Dinca-Mihai/Analog-Signal-Conditioning-Interface/AnalogSignalConditioningInterface.pdf

# Proiect SCIA

Profesor indrumator:

Alessandro Battigelli

Vladu Eduard

Student: Dinca Mihai Mircea

Anul III, EA, Grupa 2131

# Cuprins

## Capitolul 1. Cerinte de proiectare

## Specificatii generale:

## Proiectarea unei interfete analogice formate din urmatoarele blocuri conectate in cascada:

1. un preamplificator/amplificator de instrumentatie cu intrare diferentiala/single ended in tensiune/curent si iesire in tensiune/current 2. un filtru analogic trece jos/trece banda cu intrare in tensiune/curent si iesire in tensiune 3. un amplificator cu castig programabil 4. un peak detector/redresor de precizie / convertor AC-DC / circuit Sample&Hold

## Schema bloc circuit:

Figura 1- Schema Bloc Circuit

## Capitolul 2. Circuit electric – proiectare si simulare

## Etaj 1 – Amplificator

## Specificatii individuale:

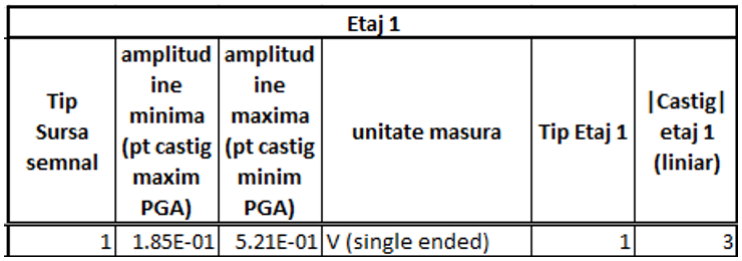
[picture p1: figure]

Figura 2 - Specificatii individuale etaj1

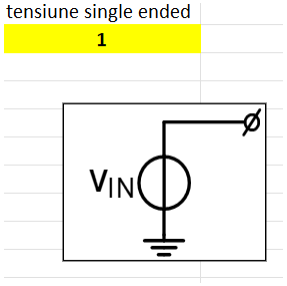
[picture p2: figure]

Figura 3 – Sursa

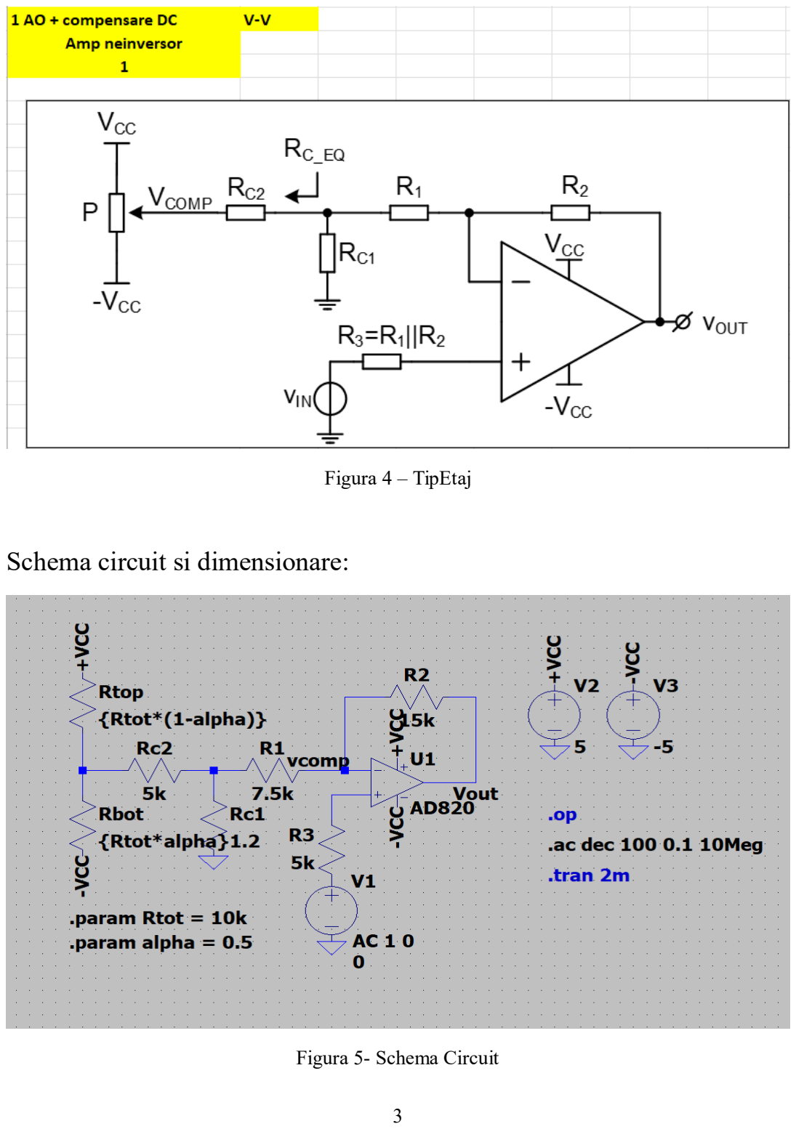
[picture p3: page 5]

Figura 4 – TipEtaj

## Schema circuit si dimensionare:

Figura 5- Schema Circuit

## Dimensionare:

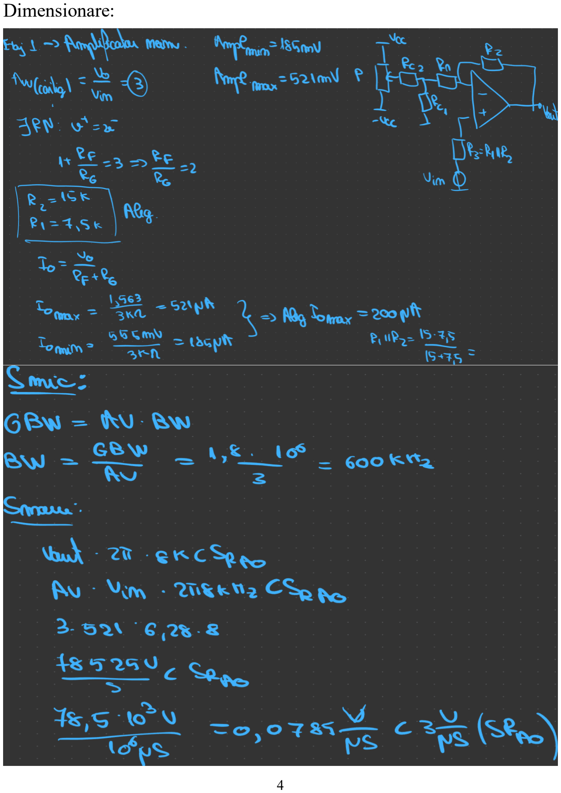
[picture p4: page 6]
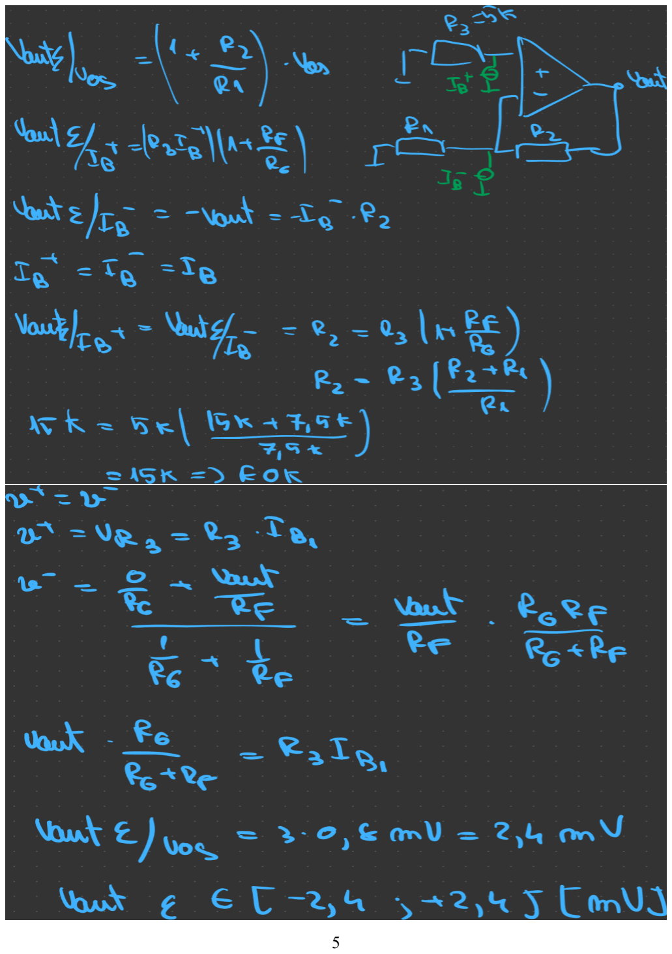
[picture p5: page 7]
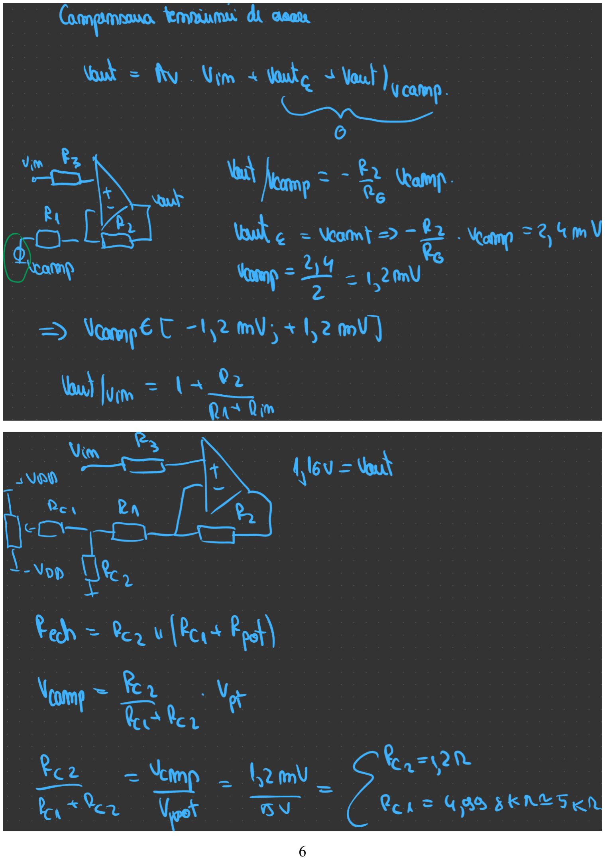
[picture p6: page 8]

## Simulari:

## - DCOP

## Punct static de functionare:

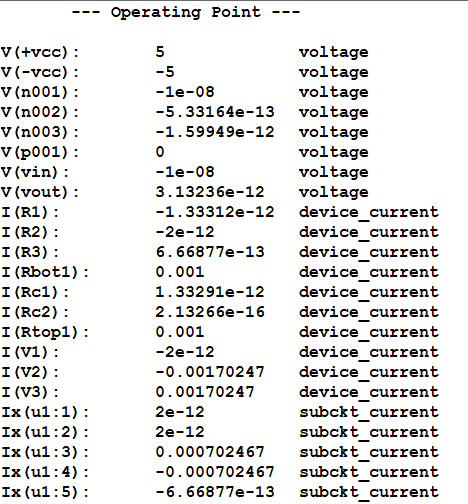
[picture p7: figure]

Figura 6 - punct static de functionare

## Compensare DC:

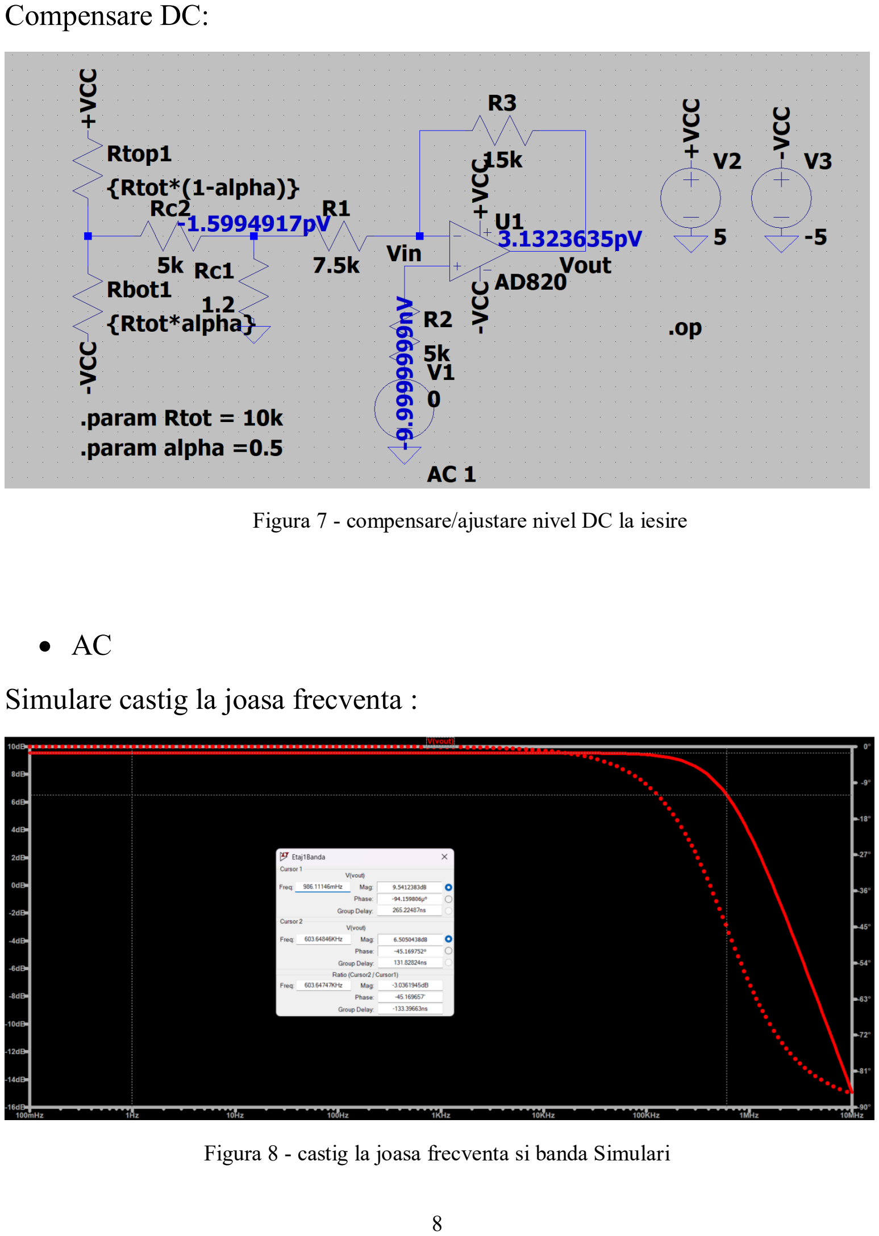
[picture p8: page 10]

Figura 7 - compensare/ajustare nivel DC la iesire

- AC

## Simulare castig la joasa frecventa :

Figura 8 - castig la joasa frecventa si banda Simulari

## Castig joasa frecventa masurat:

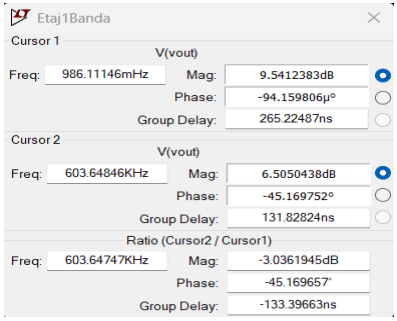
[picture p9: figure]

Figura 9 - castig la joasa frecventa si banda Masuratori

## - Transient

## Setare sursei pentru masurarea SR:

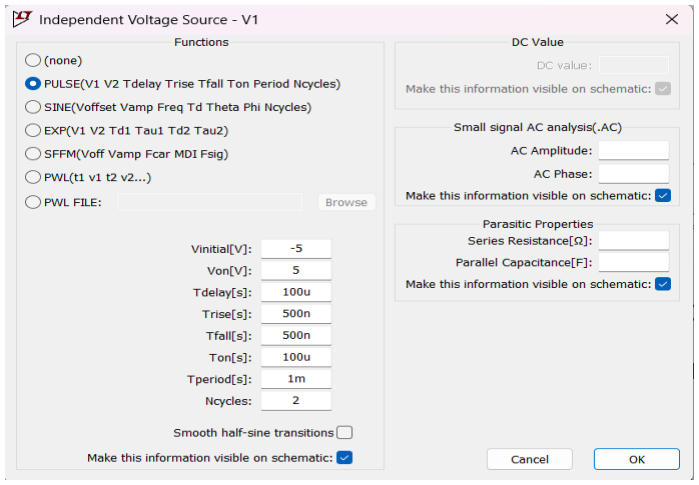
[picture p10: figure]

Figura 10 – Sursa V1 pentru masurare SR

## SR Simulare:

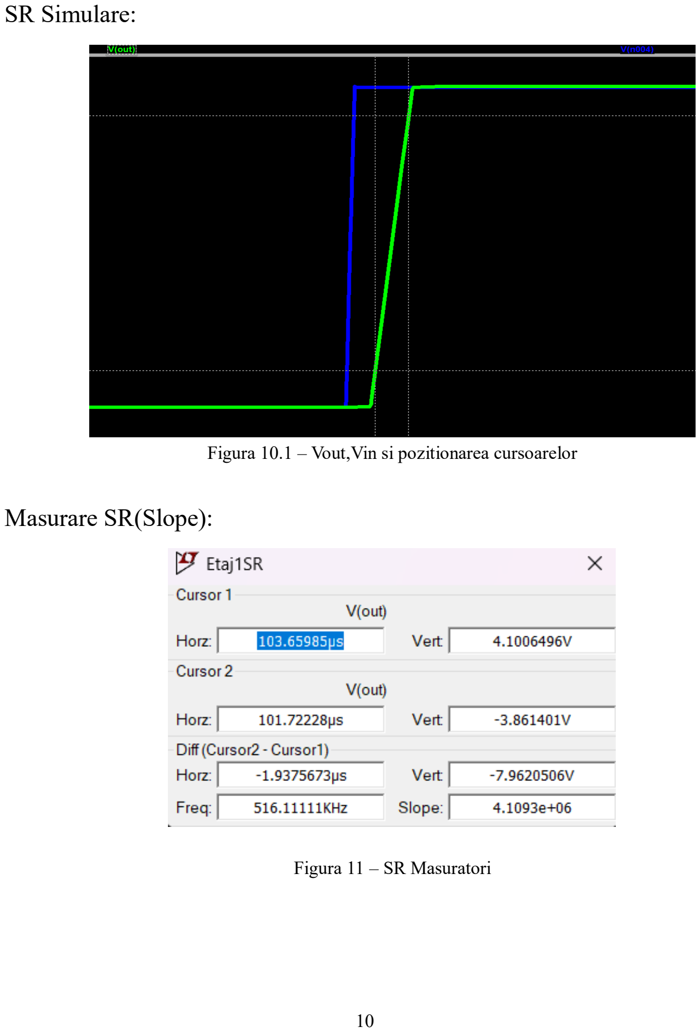
[picture p11: page 12]

Figura 10.1 – Vout,Vin si pozitionarea cursoarelor

## Masurare SR(Slope):

Figura 11 – SR Masuratori

## Analiza tranzitorie semal de iesire:

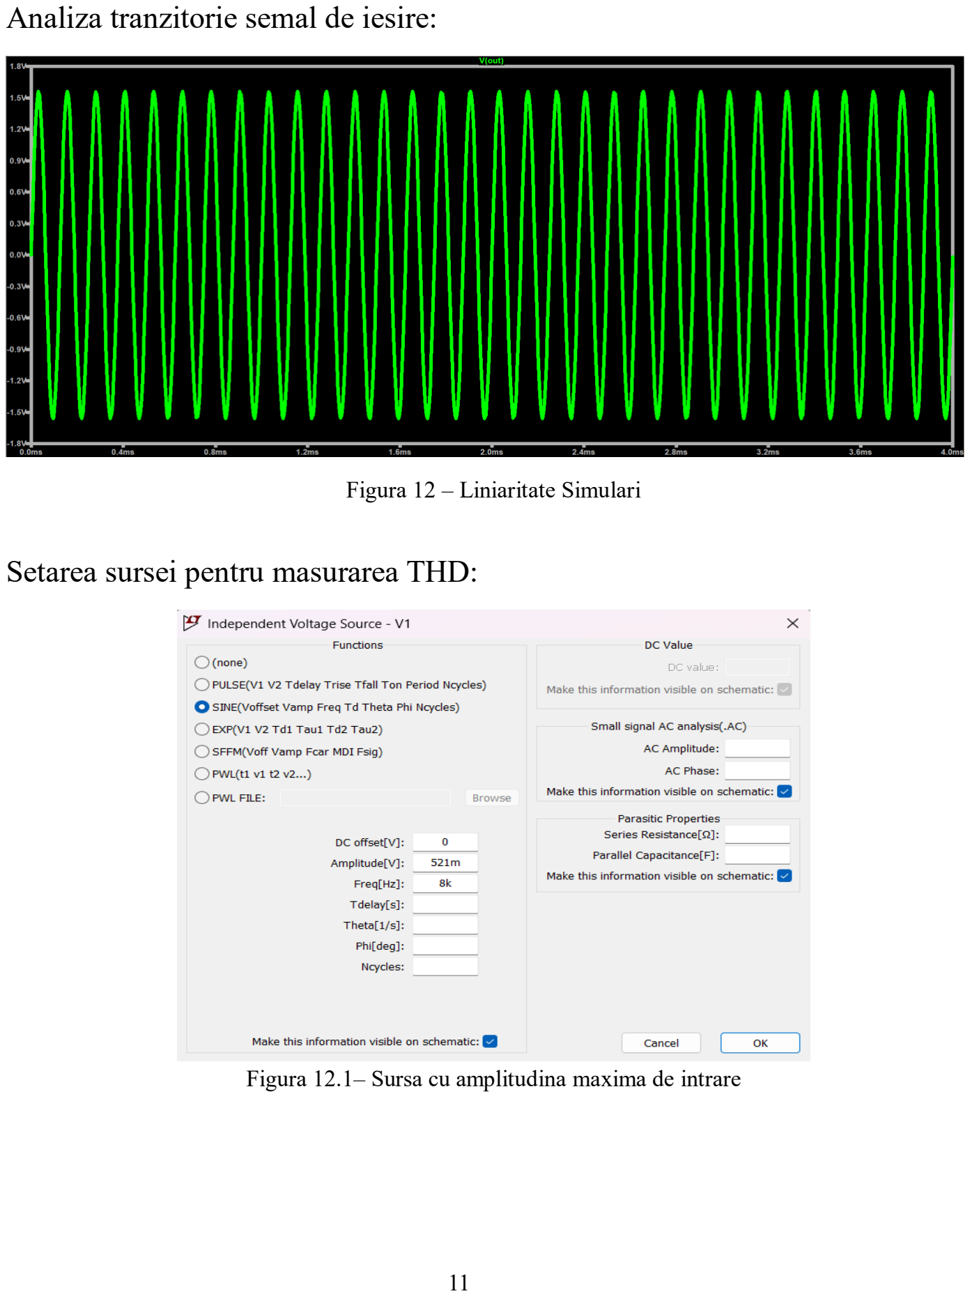
[picture p12: page 13]

Figura 12 – Liniaritate Simulari

## Setarea sursei pentru masurarea THD:

Figura 12.1– Sursa cu amplitudina maxima de intrare

## FFT:

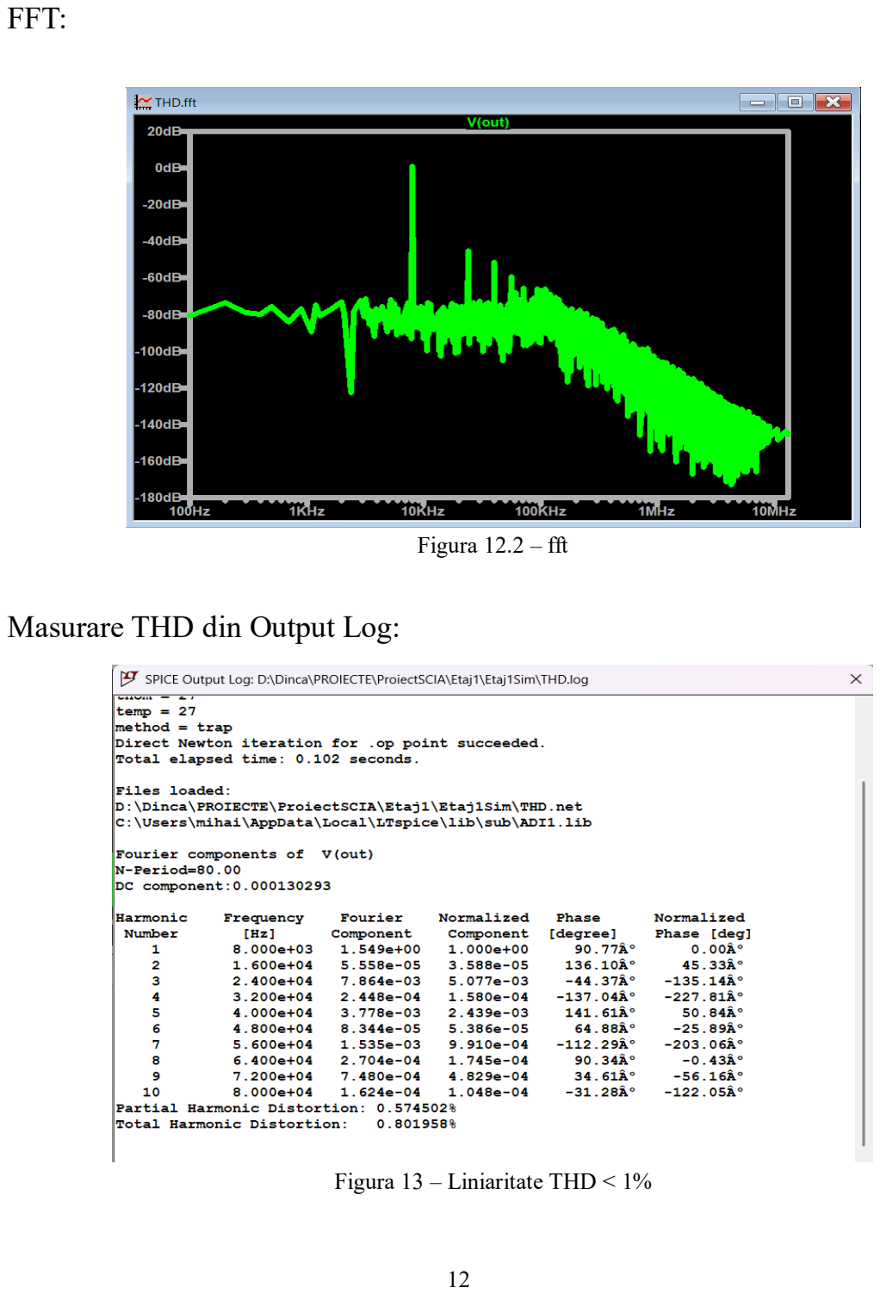
[picture p13: page 14]

Figura 12.2 – fft

## Masurare THD din Output Log:

Figura 13 – Liniaritate THD < 1%

## Etaj 2 – Filtru

## Specificatii individuale:

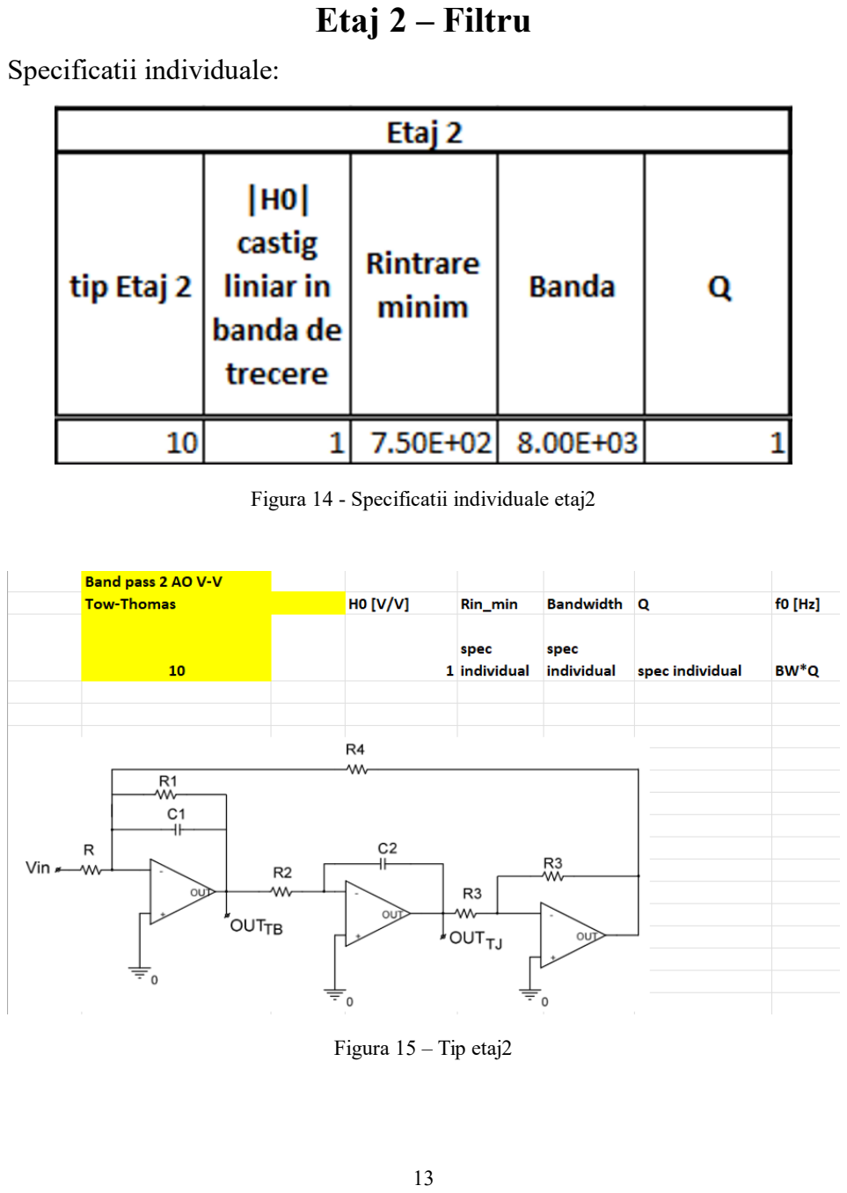
[picture p14: page 15]

Figura 14 - Specificatii individuale etaj2

Figura 15 – Tip etaj2

## Schema circuit si dimensionare:

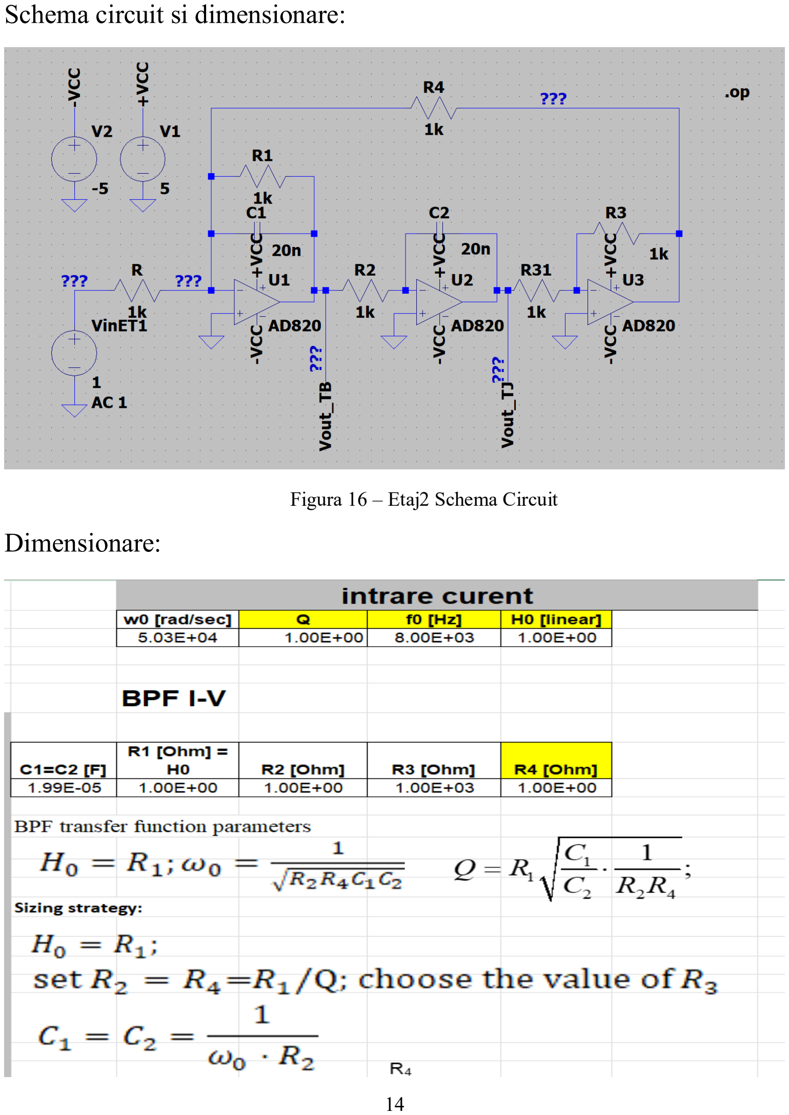
[picture p15: page 16]

Figura 16 – Etaj2 Schema Circuit

## Dimensionare:

## Simulari:

## - DCOP

## Punct static de functionare:

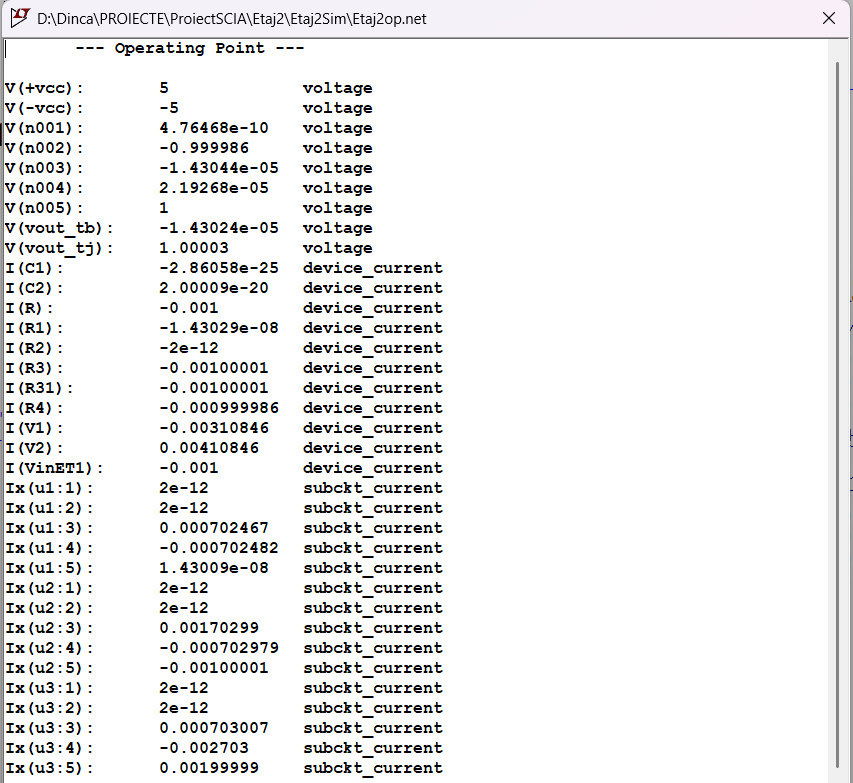
[picture p16: figure]

Figura 17 – OP

- AC

## Banda de trecere:

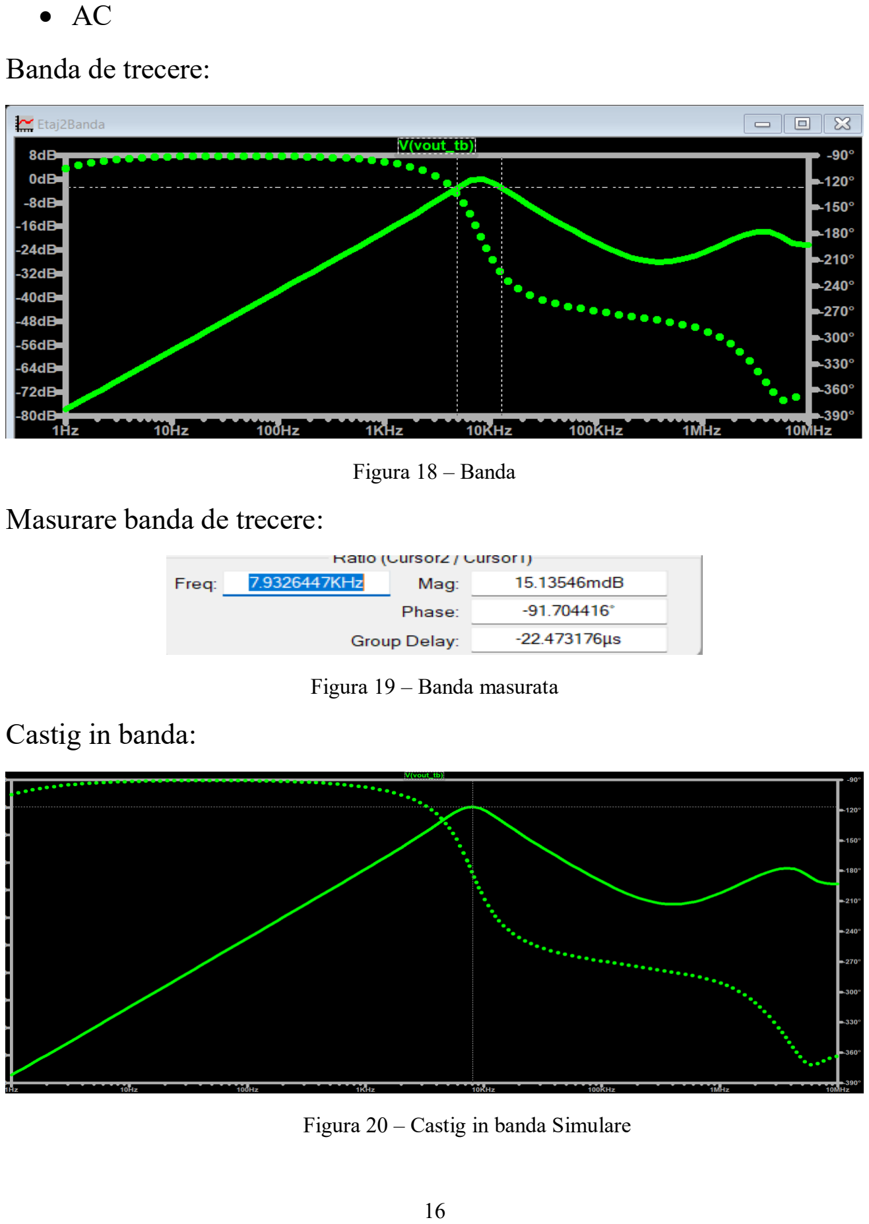
[picture p17: page 18]

Figura 18 – Banda

## Masurare banda de trecere:

Figura 19 – Banda masurata

## Castig in banda:

Figura 20 – Castig in banda Simulare

## Banda masurata:

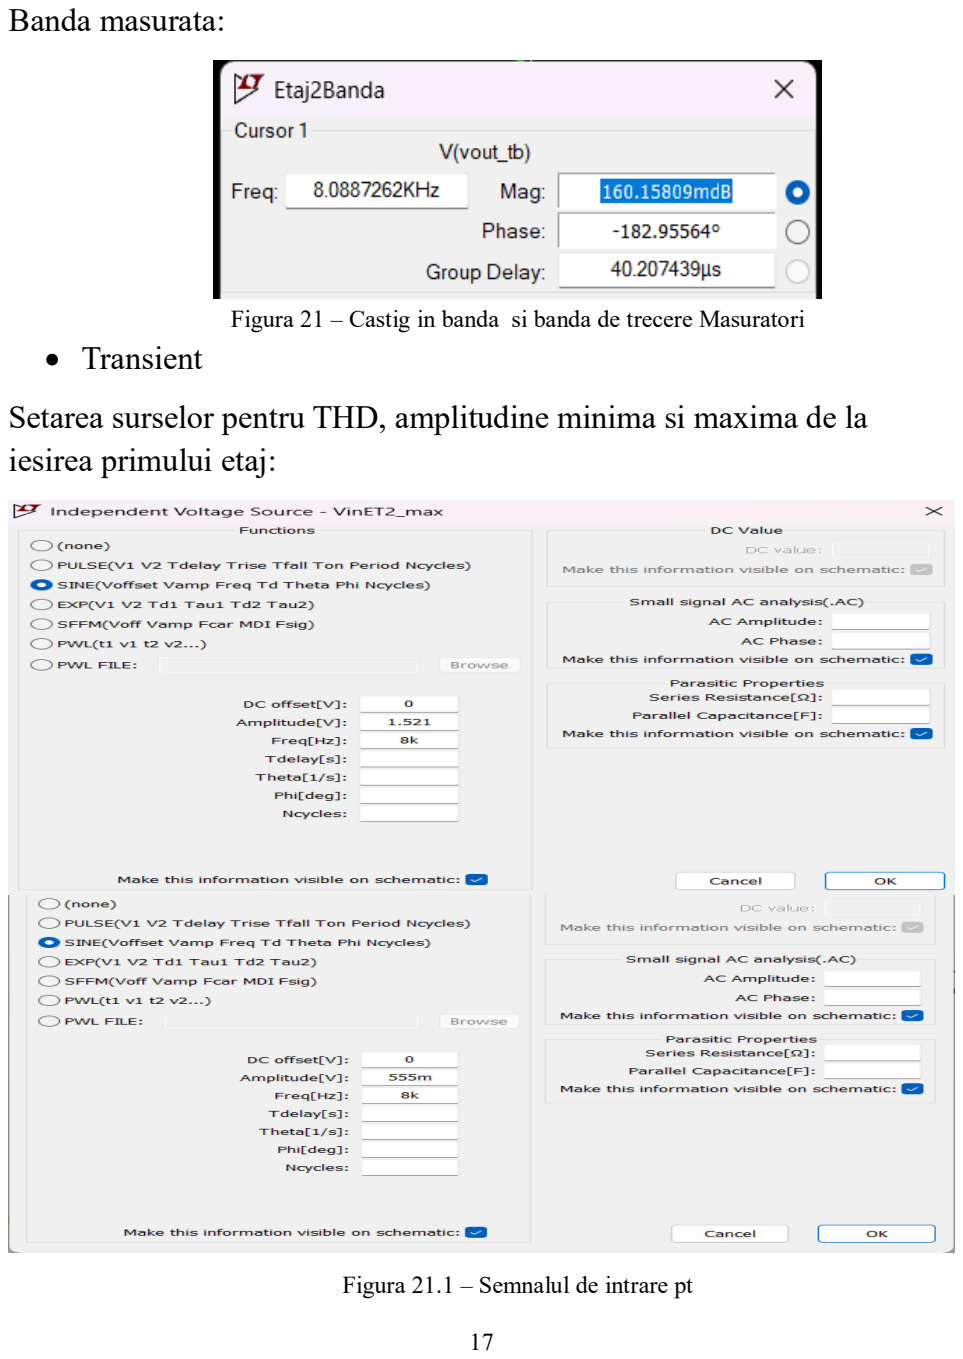
[picture p18: page 19]

Figura 21 – Castig in banda si banda de trecere Masuratori

## - Transient

## Setarea surselor pentru THD, amplitudine minima si maxima de la iesirea primului etaj:

Figura 21.1 – Semnalul de intrare pt

## Liniaritate Vout:

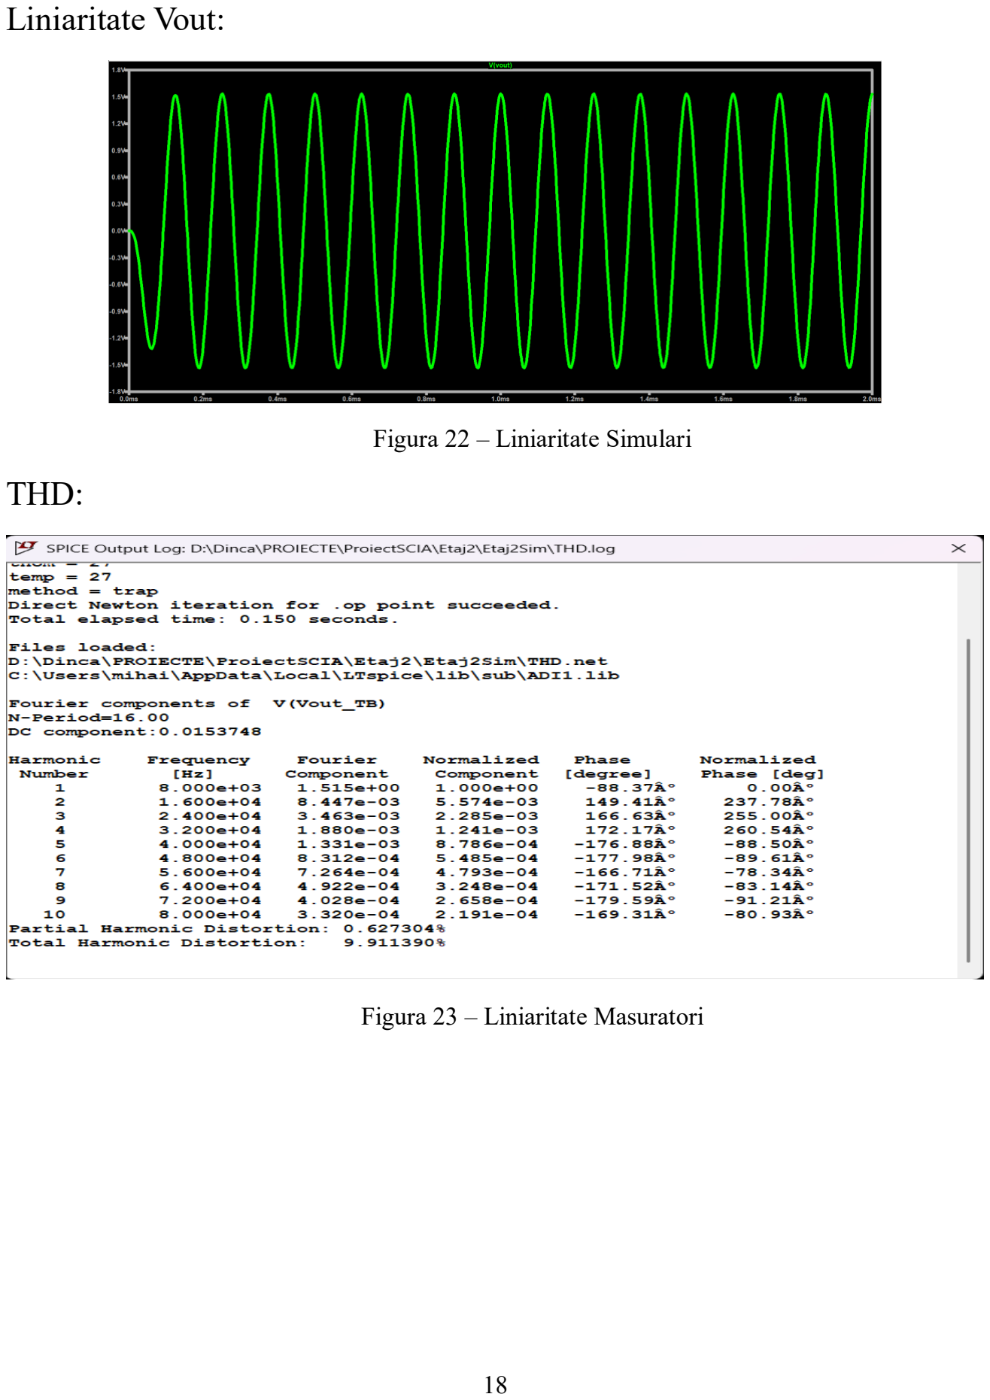
[picture p19: page 20]

Figura 22 – Liniaritate Simulari

## THD:

Figura 23 – Liniaritate Masuratori

## Etaj 3 – PGA

## Specificatii individuale:

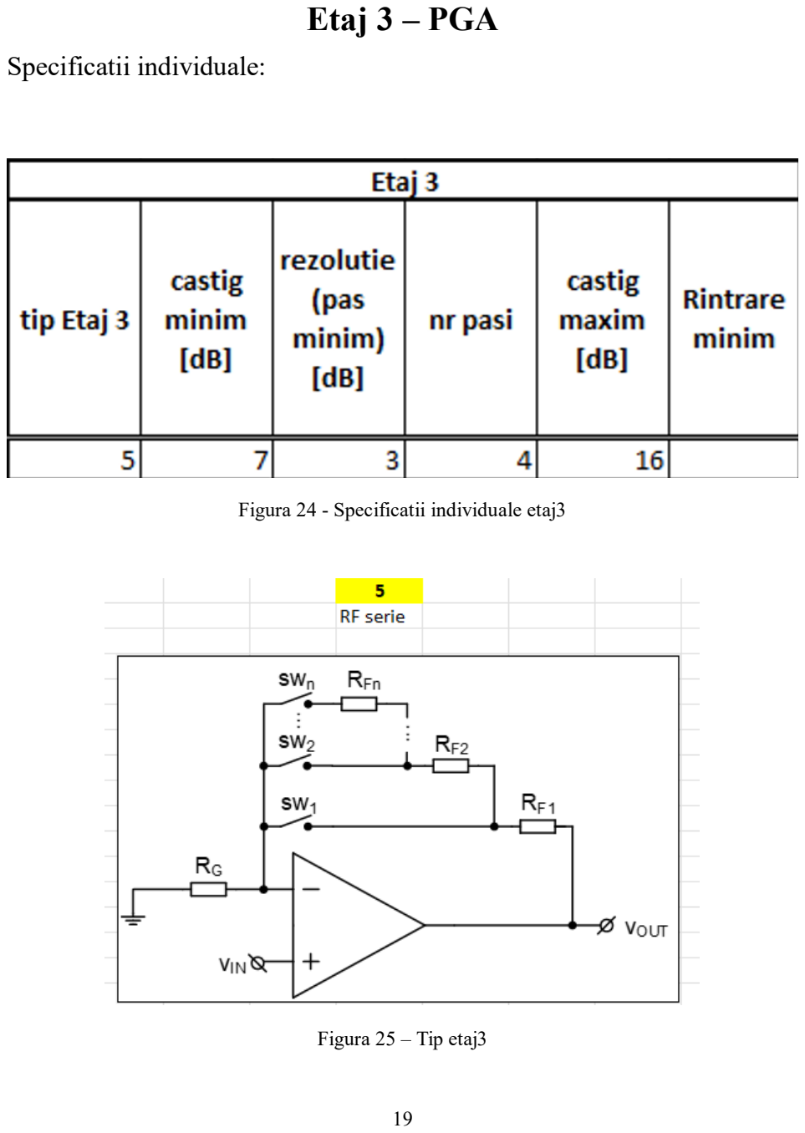
[picture p20: page 21]

Figura 24 - Specificatii individuale etaj3

Figura 25 – Tip etaj3

## Schema circuit:

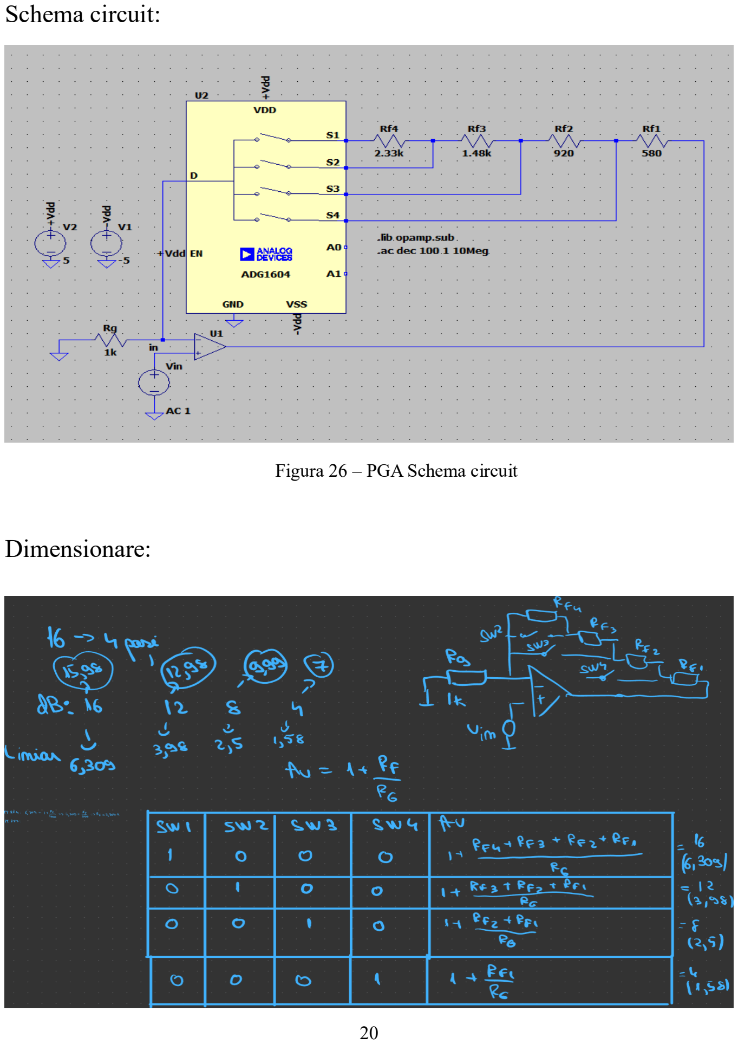
[picture p21: page 22]

Figura 26 – PGA Schema circuit

## Dimensionare:

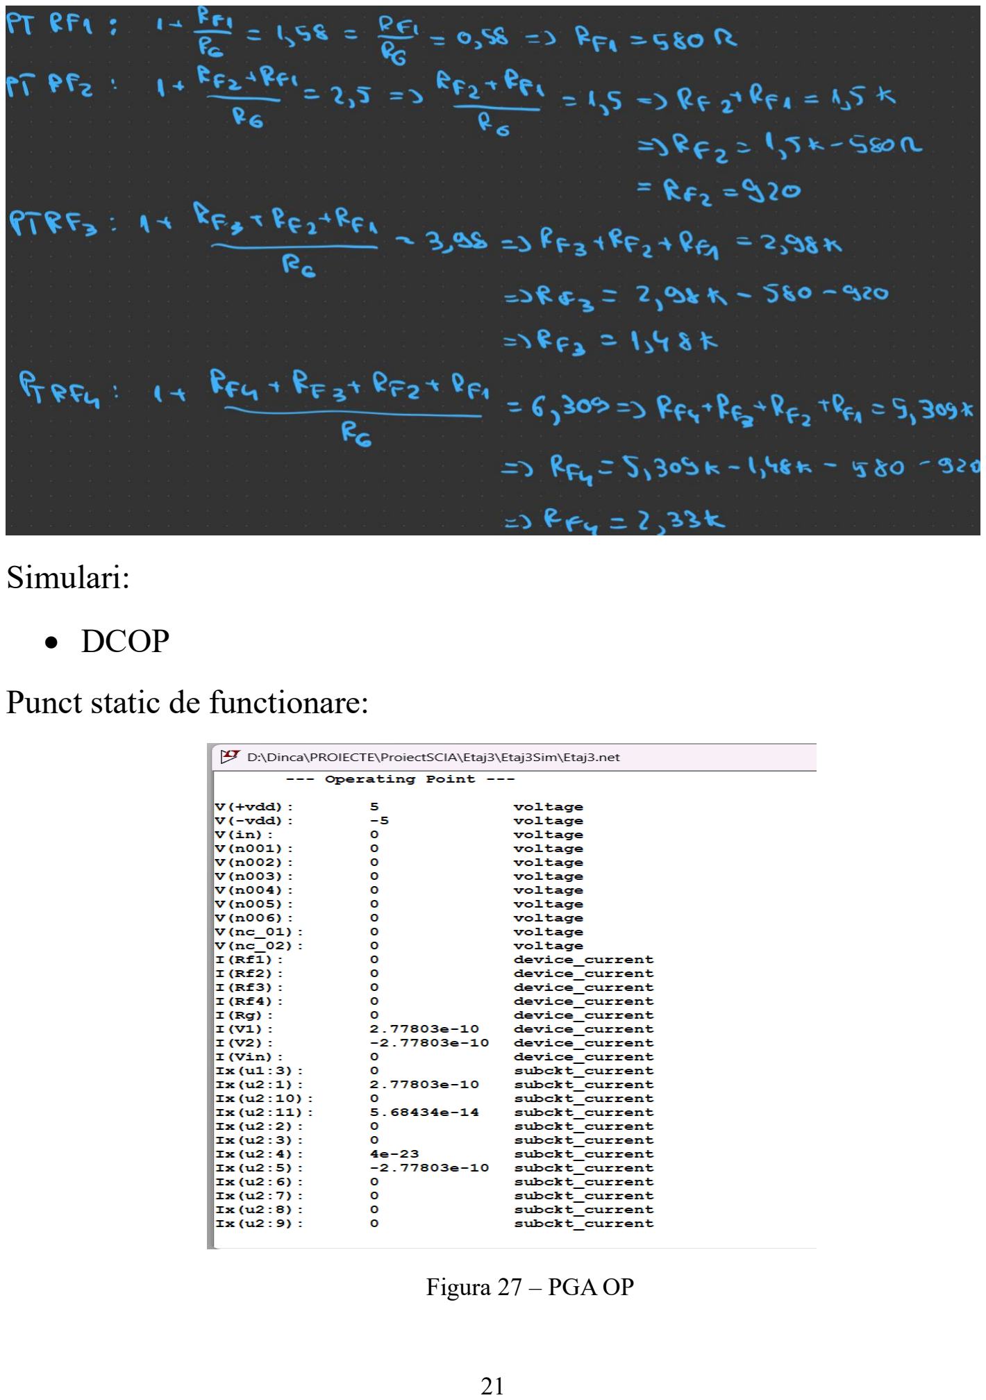
[picture p22: page 23]

## Simulari:

## - DCOP

## Punct static de functionare:

Figura 27 – PGA OP

- AC

## Amplificare SW-1 ON:

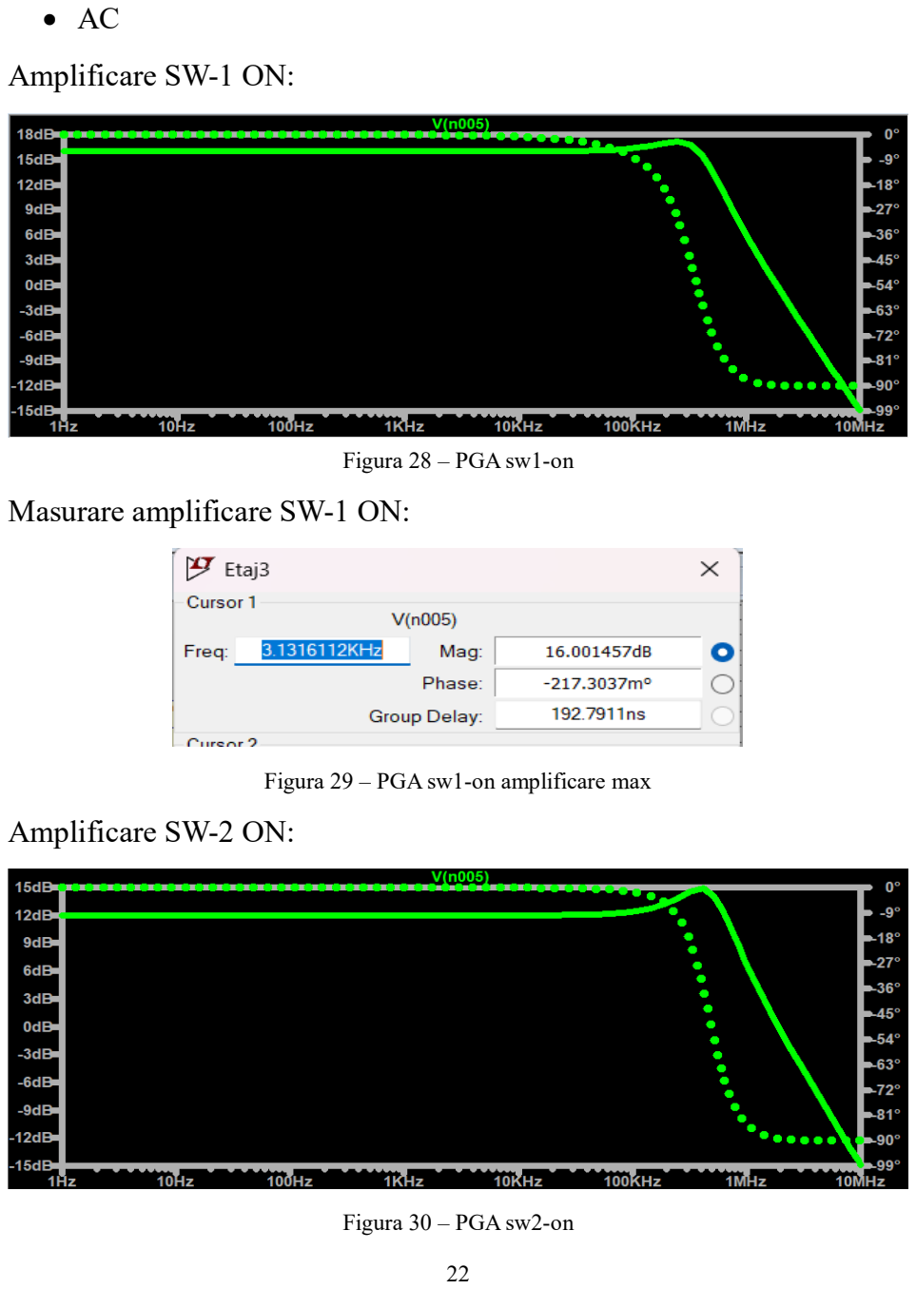
[picture p23: page 24]

Figura 28 – PGA sw1-on

## Masurare amplificare SW-1 ON:

Figura 29 – PGA sw1-on amplificare max

## Amplificare SW-2 ON:

Figura 30 – PGA sw2-on

## Masurare amplificare SW-2 ON:

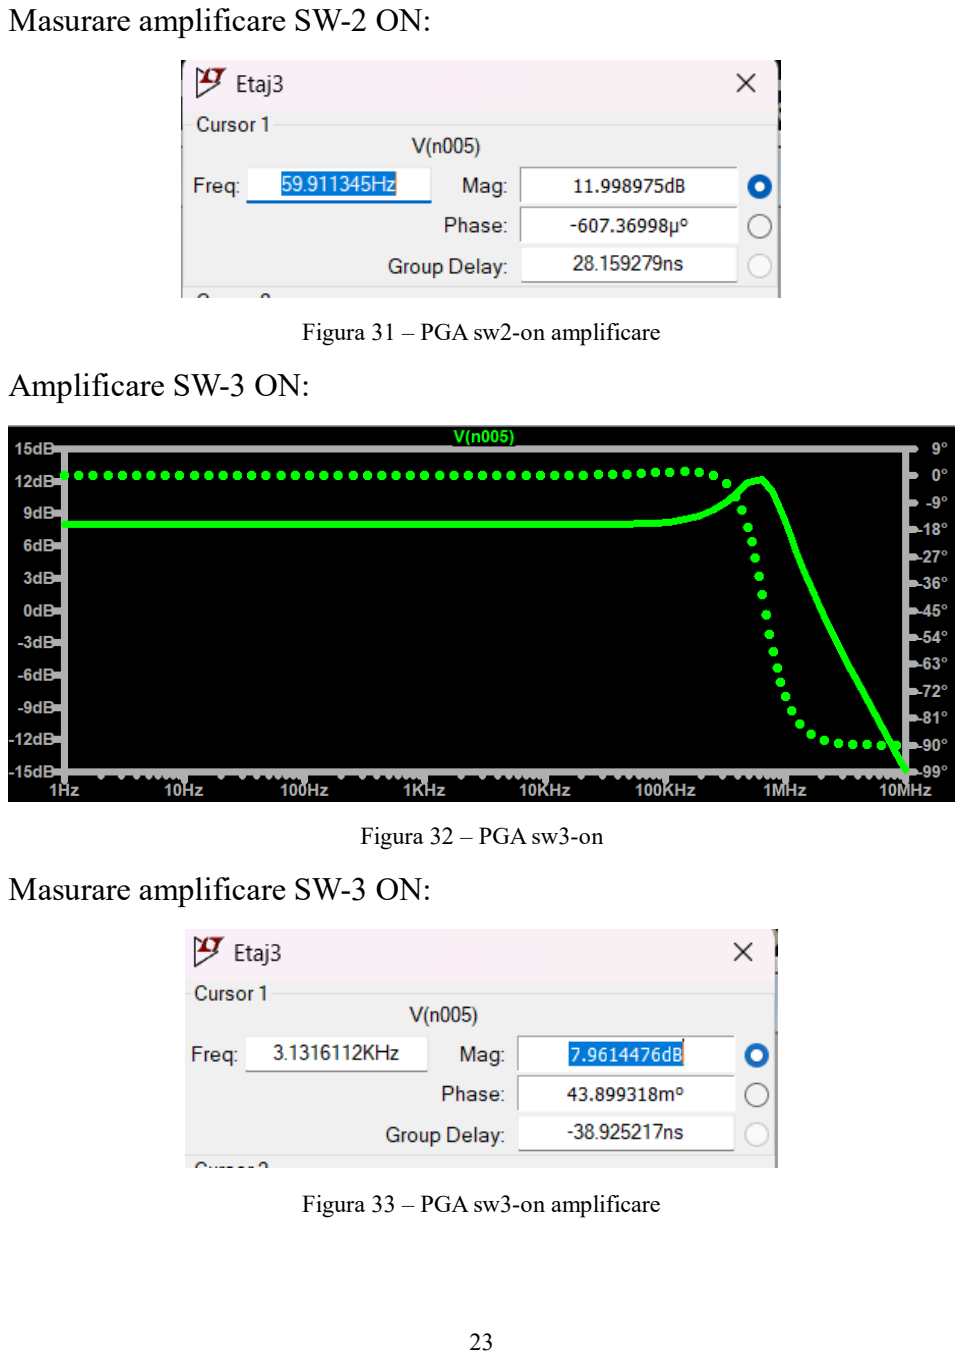
[picture p24: page 25]

Figura 31 – PGA sw2-on amplificare

## Amplificare SW-3 ON:

Figura 32 – PGA sw3-on

## Masurare amplificare SW-3 ON:

Figura 33 – PGA sw3-on amplificare

## Amplificare SW-4 ON:

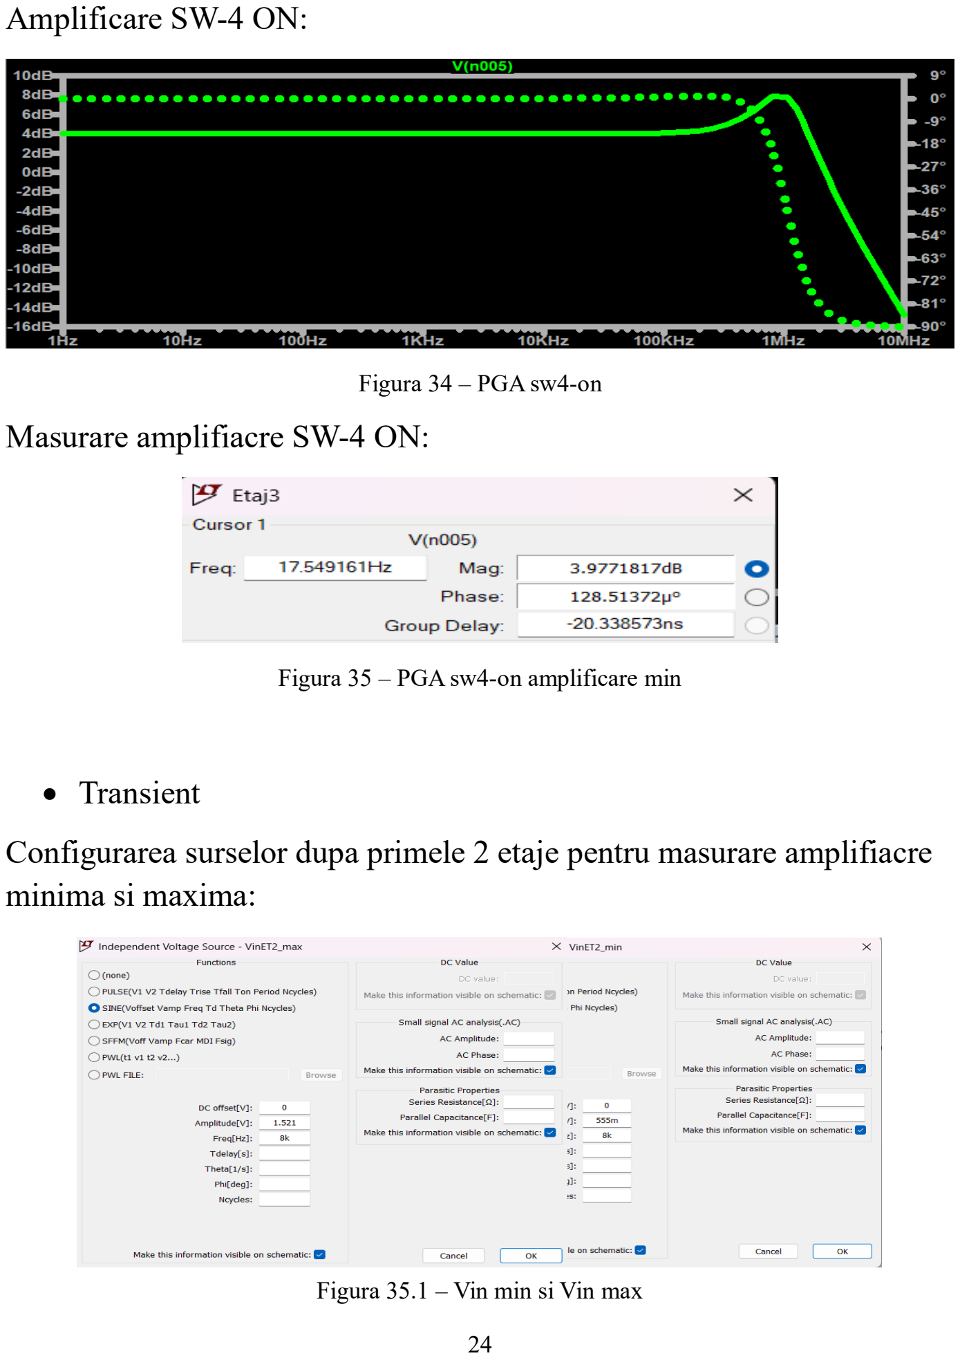
[picture p25: page 26]

Figura 34 – PGA sw4-on

## Masurare amplifiacre SW-4 ON:

Figura 35 – PGA sw4-on amplificare min

## - Transient

## Configurarea surselor dupa primele 2 etaje pentru masurare amplifiacre minima si maxima:

Figura 35.1 – Vin min si Vin max

## Vout la amplificare maxima(Vin min):

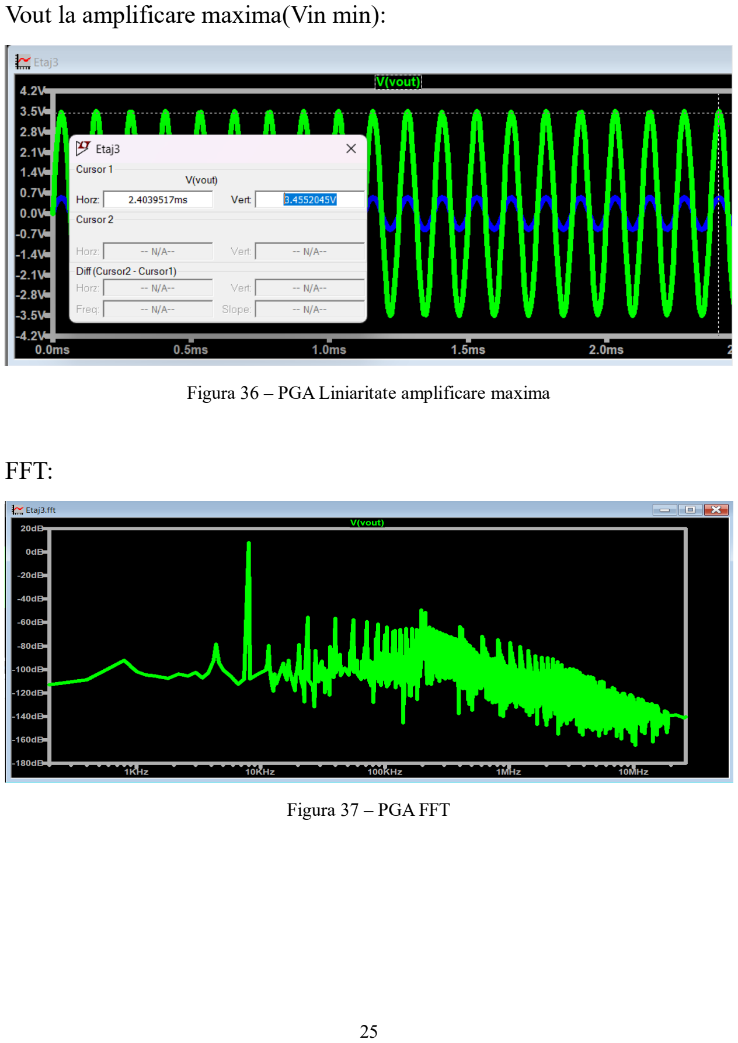
[picture p26: page 27]

Figura 36 – PGA Liniaritate amplificare maxima

## FFT:

Figura 37 – PGA FFT

## Masurare THD amplificare maxima:

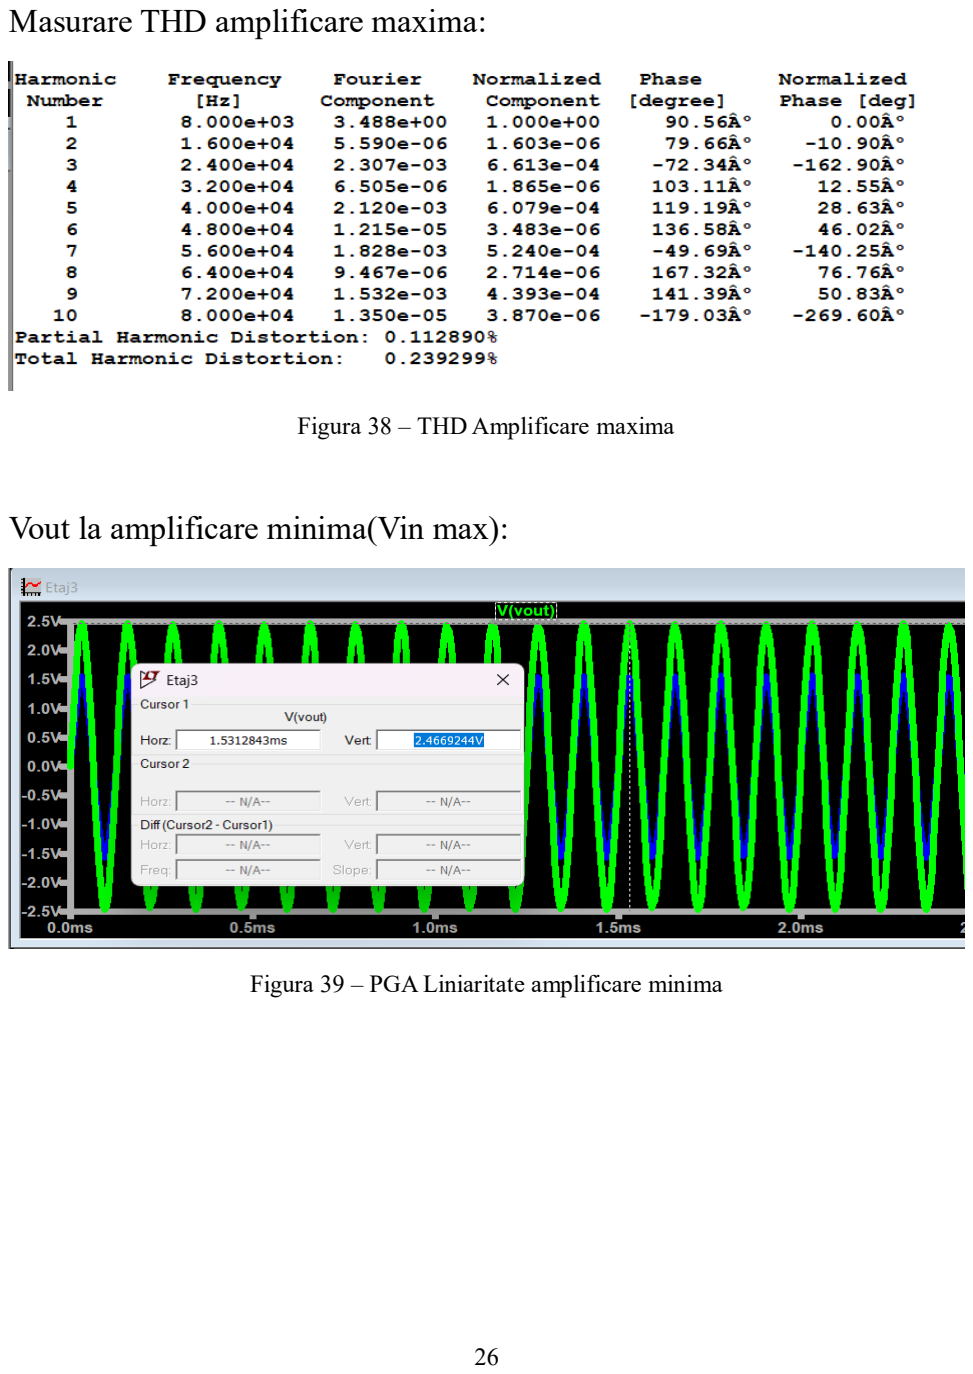
[picture p27: page 28]

Figura 38 – THD Amplificare maxima

## Vout la amplificare minima(Vin max):

Figura 39 – PGA Liniaritate amplificare minima

## FFT:

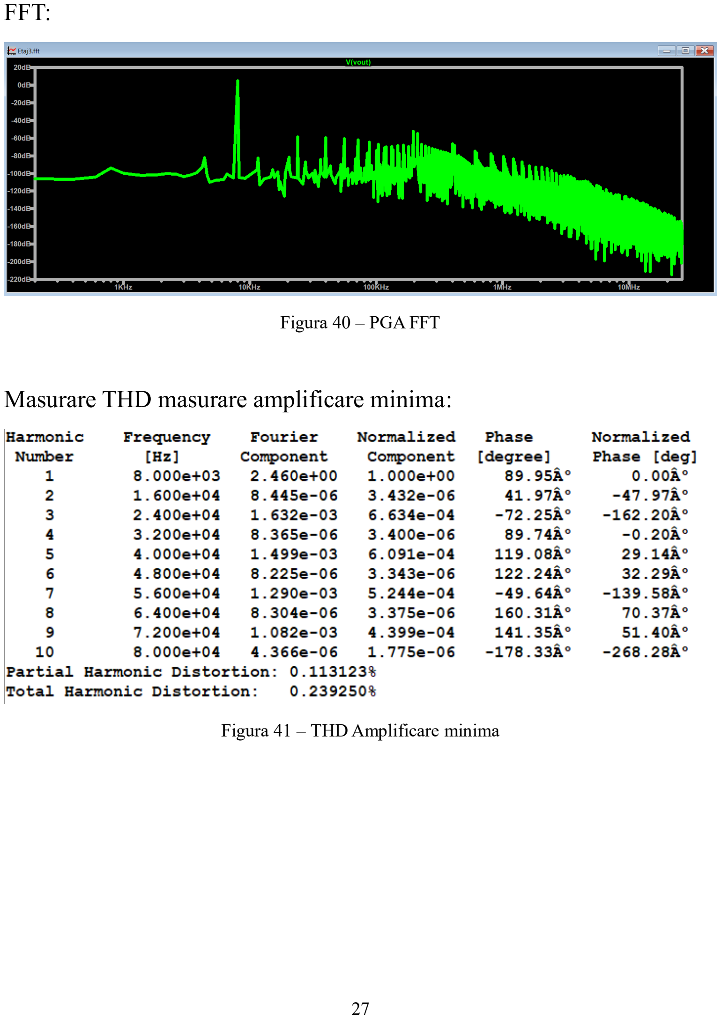
[picture p28: page 29]

Figura 40 – PGA FFT

## Masurare THD masurare amplificare minima:

Figura 41 – THD Amplificare minima

## Etaj 4 – Redresor

## Specificatii individuale:

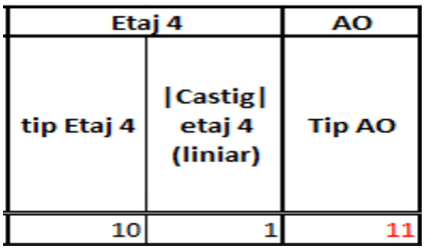
[picture p29: figure]

Figura 42 - Specificatii individuale etaj4

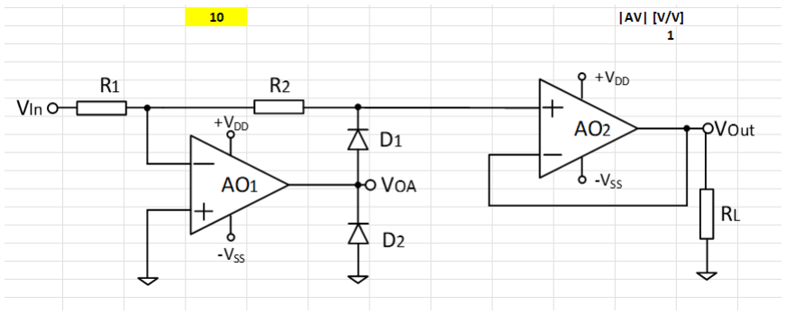
[picture p30: figure]

Figura 43 – Tip etaj4

## Schema circuit si dimensionare:

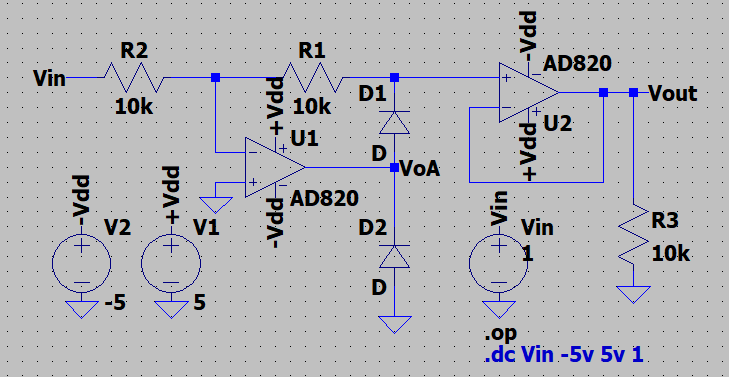
[picture p31: figure]

Figura 44 –Schema circuit etaj4

## Simulari:

## - DCOP

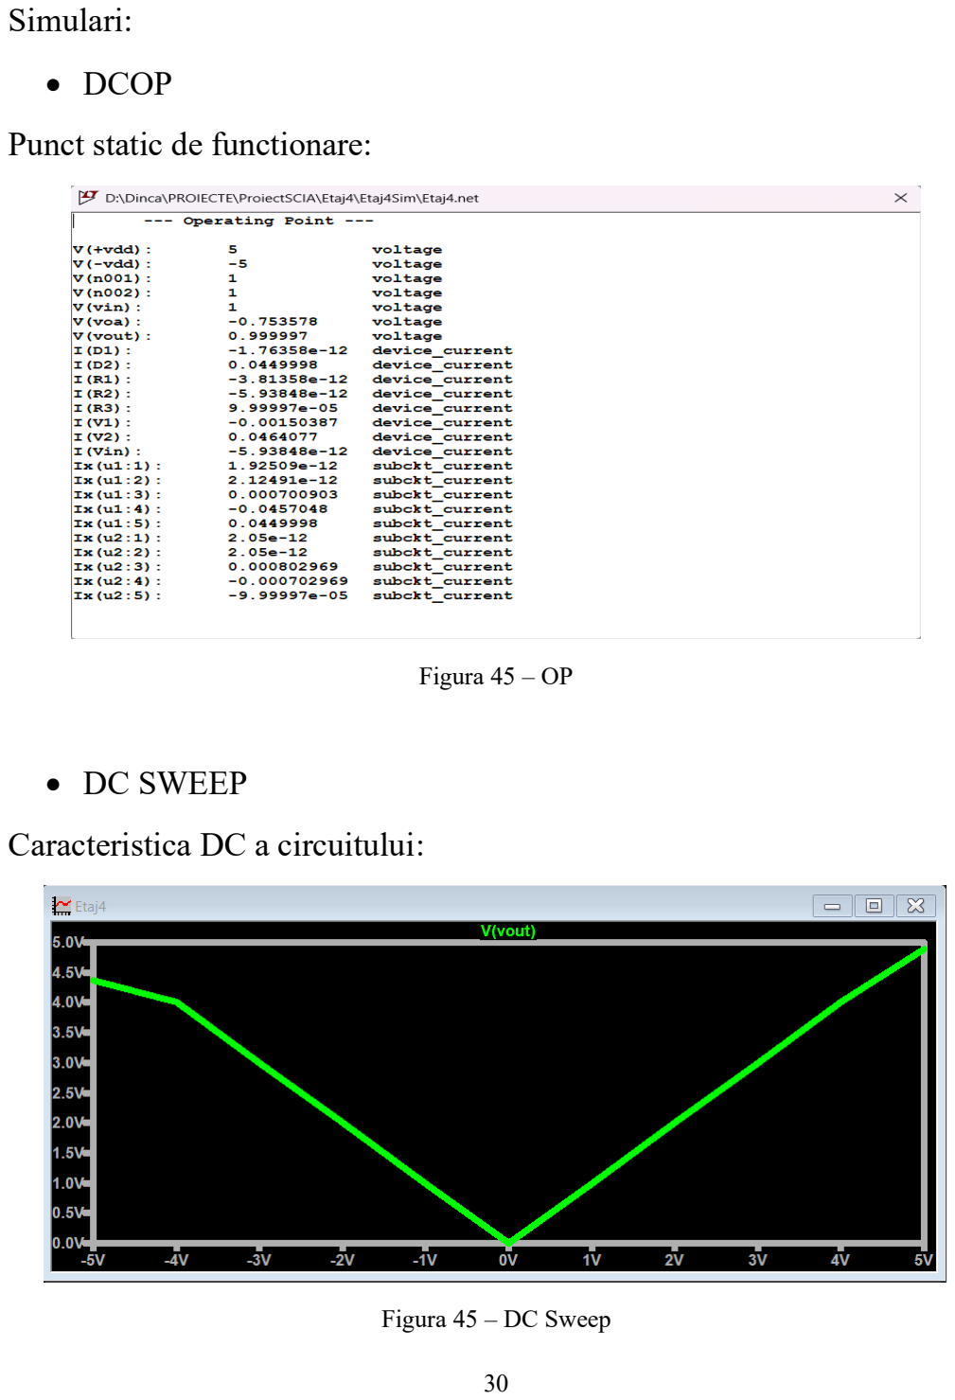
[picture p32: page 32]

## Punct static de functionare:

Figura 45 – OP

## - DC SWEEP

## Caracteristica DC a circuitului:

Figura 45 – DC Sweep

## - Transient

## Indeplinirea functiei de circuit pentru amplificare minima si pentru

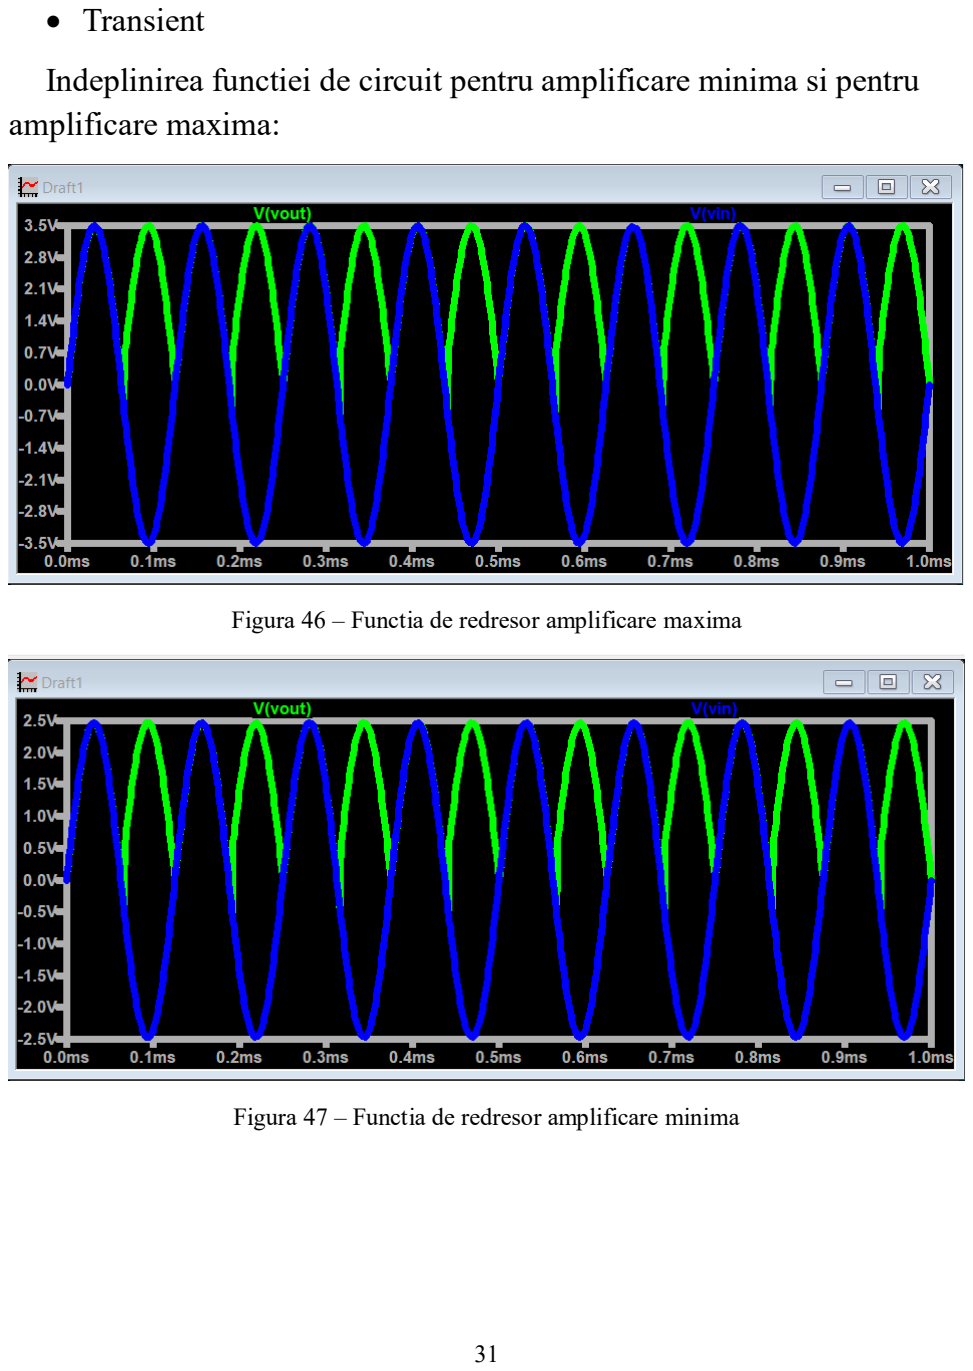
[picture p33: page 33]

## amplificare maxima:

Figura 46 – Functia de redresor amplificare maxima

Figura 47 – Functia de redresor amplificare minima

## Capitolul 3. Implementare circuit

## Etajul 1

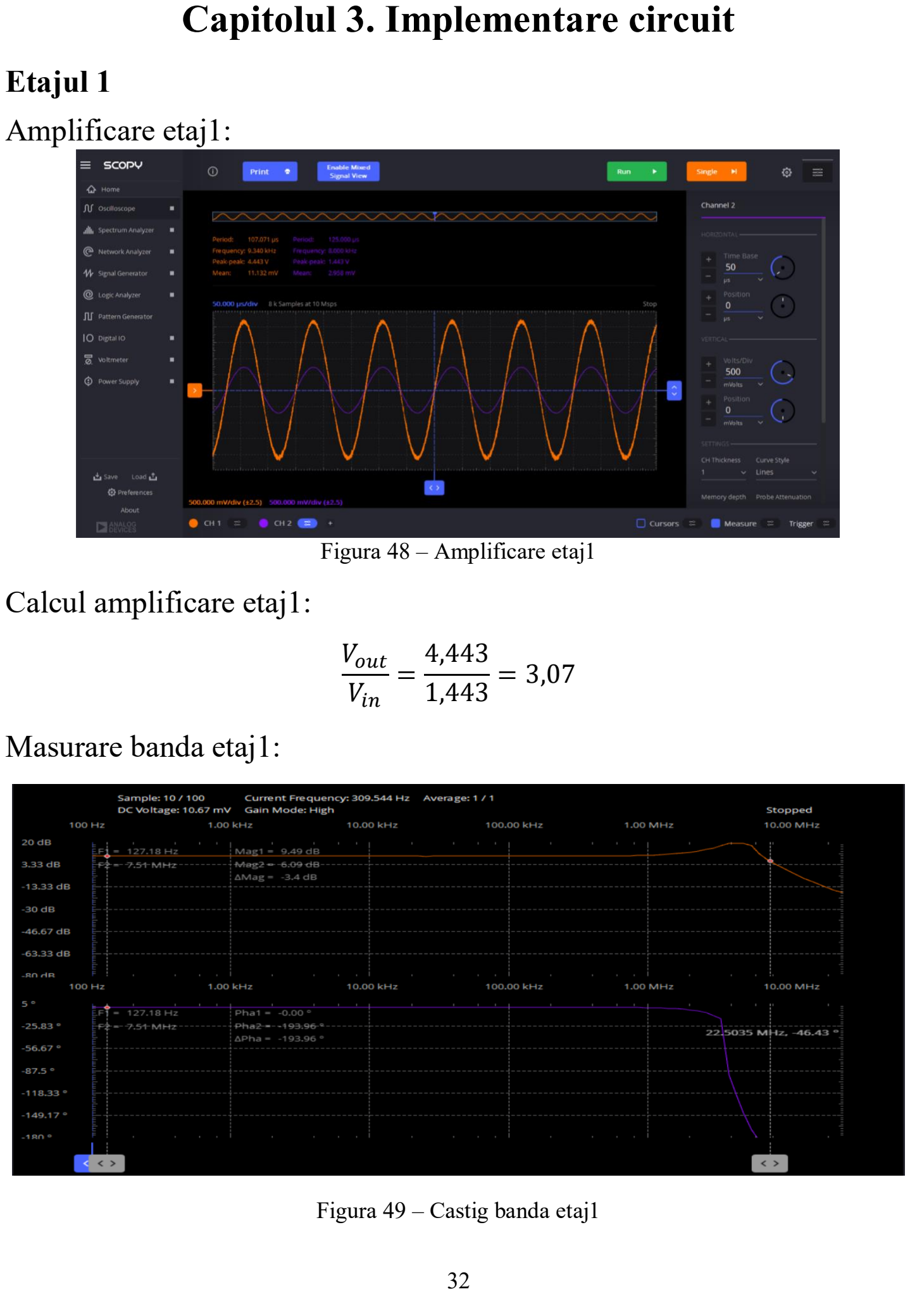
[picture p34: page 34]

## Amplificare etaj1:

Figura 48 – Amplificare etaj1

## Calcul amplificare etaj1:

Vout

Vin

=

4,443
1,443 = 3,07

## Masurare banda etaj1:

Figura 49 – Castig banda etaj1

## GBW pentru LT1357 este de 25Mhz:

## 25Mℎz

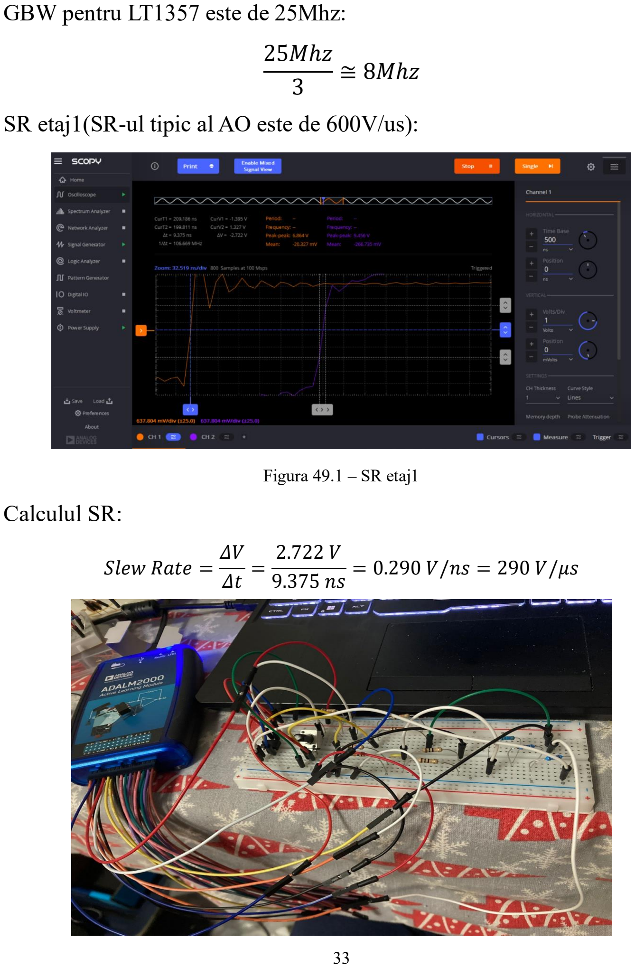
[picture p35: page 35]

3

## ≅ 8Mℎz

## SR etaj1(SR-ul tipic al AO este de 600V/us):

Figura 49.1 – SR etaj1

## Calculul SR:

### Slew Rate =

ΔV
Δt =

2.722 V
9.375 ns

### = 0.290 V/ns = 290 V/μs

## Etajul 2

## Amplificare etaj2:

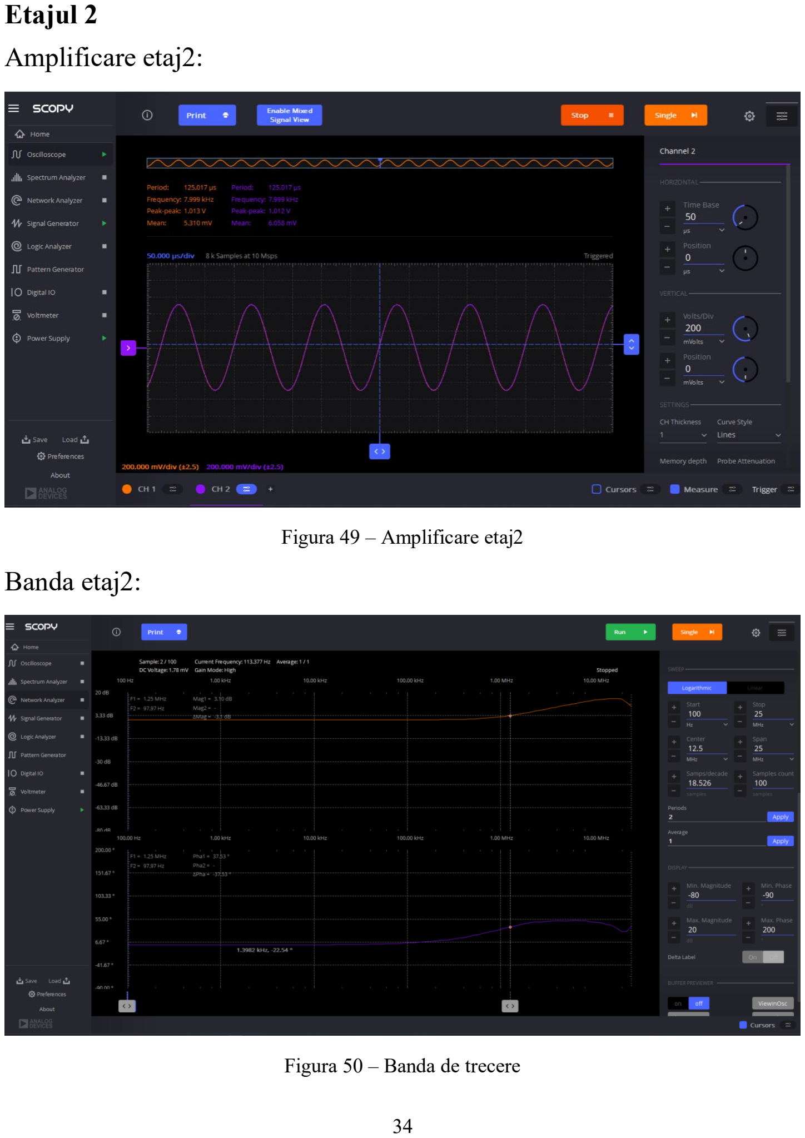
[picture p36: page 36]

Figura 49 – Amplificare etaj2

## Banda etaj2:

Figura 50 – Banda de trecere

## Atenuarea semnalelor la frecvente mari(1Mhz):

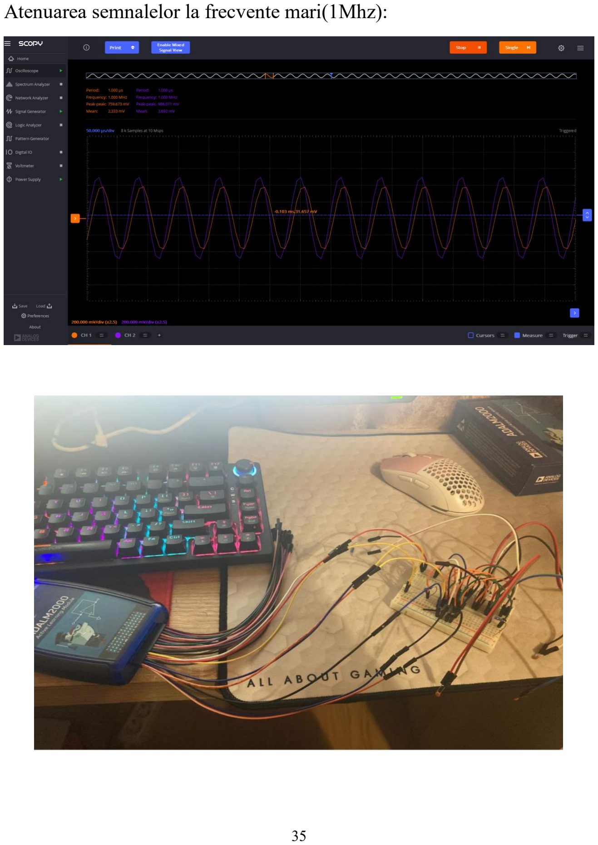
[picture p37: page 37]

## Etajul 4

## Indeplinirea functiei circuitului:

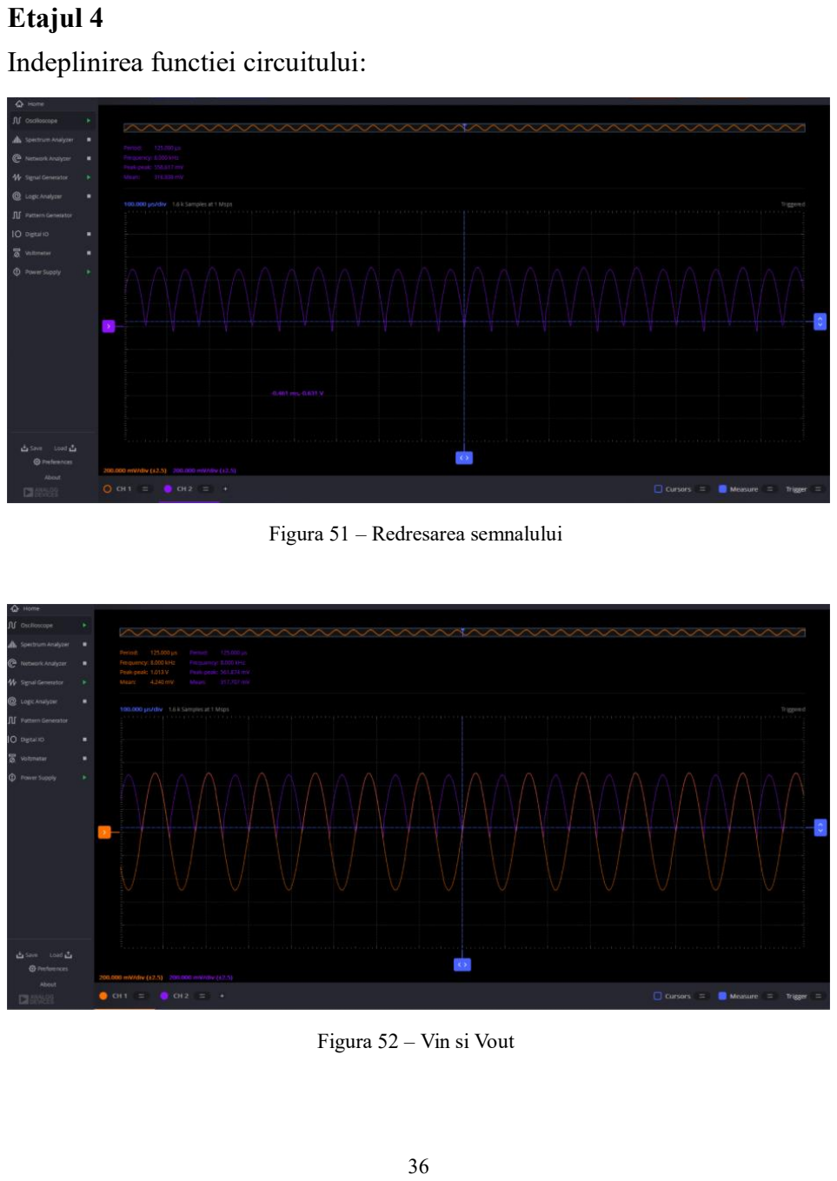
[picture p38: page 38]

Figura 51 – Redresarea semnalului

Figura 52 – Vin si Vout

## Circuitul

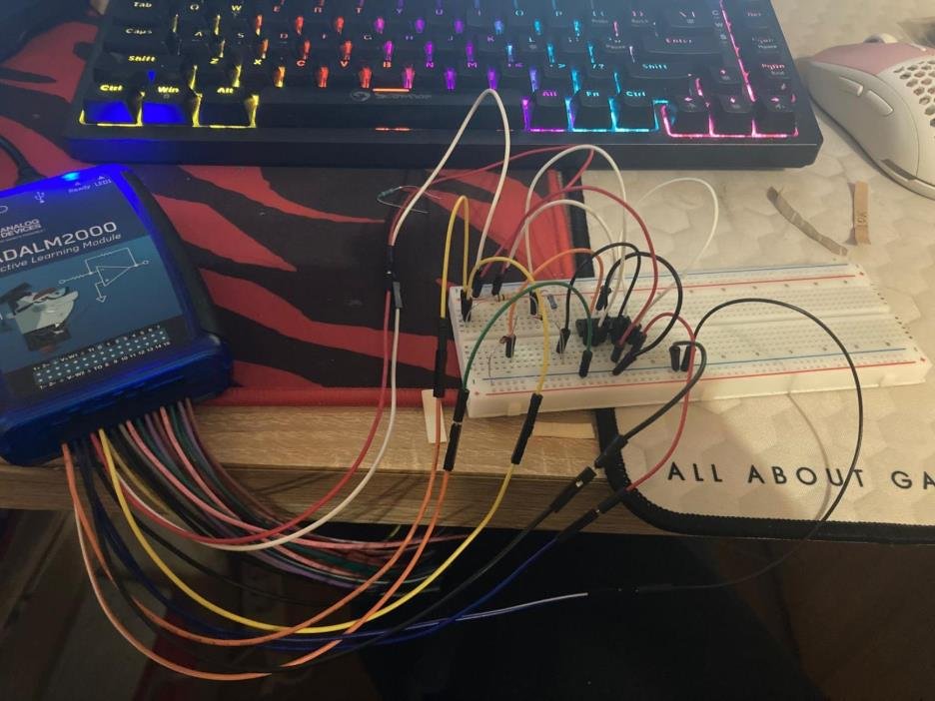
[picture p39: figure]

Figura 53– Circuitul
