Dinca-Mihai/Analog-Signal-Conditioning-Interface/Etaj1Banda.asc

R1: res; 7.5k
R2: res; 15k
R3: res; 5k
Rbot: res; {Rtot*alpha}
Rc1: res; 1.2
Rc2: res; 5k
Rtop: res; {Rtot*(1-alpha)}
U1: opamp
V1: voltage; ""; AC 1
V2: voltage; 5
V3: voltage; -5
Named nets: 0, +VCC, -VCC, Vin, Vout
.param Rtot = 10k
.param alpha =0.5
.op
.ac dec 100 0.1 10Meg
.lib opamp.sub
