Dinca-Mihai/Analog-Signal-Conditioning-Interface/Etaj1SR.asc

R1: res; 7.5k
R2: res; 15k
R3: res; 5k
Rbot: res; {Rtot*alpha}
Rc1: res; 1.2
Rc2: res; 5k
Rtop: res; {Rtot*(1-alpha)}
U1: AD820
V1: voltage; PULSE(-5 5 100u 500n 500n 100u 1m 2)
V2: voltage; 5
V3: voltage; -5
Named nets: 0, +VCC, -VCC, out
.param Rtot = 10k
.param alpha =0.5
.op
.ac dec 100 0.1 10Meg
.tran 0 0.3m 0
.four 8k 10-1 V(out)
