Dinca-Mihai/Analog-Signal-Conditioning-Interface/Etaj2_Ideal.asc

C1: cap; 20n
C2: cap; 20n
R1: res; 1k
R2: res; 1k
R3: res; 1k
R4: res; 1k
R5: res; 20n
R6: res; 1k
U1: opamp
U2: opamp
U3: opamp
V1: voltage; 5
V2: voltage; -5
VinET1: voltage; ""; AC 1
Named nets: 0, +VCC, -VCC, Vout_TB, Vout_TJ
.ac dec 100 0.1 2Meg
.lib opamp.sub
