Dinca-Mihai/Analog-Signal-Conditioning-Interface/Etaj2Banda.asc

C1: cap; 20n
C2: cap; 20n
R1: res; 1k
R2: res; 1k
R3: res; 1k
R4: res; 1k
R5: res; 1k
R6: res; 1k
U1: AD820
U2: AD820
U3: AD820
V1: voltage; 5
V2: voltage; -5
VinET1: voltage; ""; AC 1
Named nets: 0, +VCC, -VCC, Vout_TB, Vout_TJ
.ac dec 100 1 10Meg
