Dinca-Mihai/Analog-Signal-Conditioning-Interface/Etaj2op.asc

C1: cap; 20n
C2: cap; 20n
R1: res; 1k
R2: res; 1k
R3: res; 1k
R4: res; 1k
R31: res; 1k
R: res; 1k
U1: AD820
U2: AD820
U3: AD820
V1: voltage; 5
V2: voltage; -5
VinET1: voltage; 1; AC 1
Named nets: 0, +VCC, -VCC, Vout_TB, Vout_TJ
.op
