Dinca-Mihai/Analog-Signal-Conditioning-Interface/Etaj3.asc

Rf1: res; 580
Rf2: res; 920
Rf3: res; 1.48k
Rf4: res; 2.33k
Rg: res; 1k
U1: opamp
U2: ADG1604
V1: voltage; -5
V2: voltage; 5
Vin: voltage; ""; AC 1
Named nets: 0, in, +Vdd, -Vdd
.lib opamp.sub
.ac dec 100 1 10Meg
.op
