Dinca-Mihai/Analog-Signal-Conditioning-Interface/Etaj4 (2).asc

D1: diode
D2: diode
R1: res; 10k
R2: res; 10k
R3: res; 10k
U1: AD820
U2: AD820
V1: voltage; 5
V2: voltage; -5
Vin1: voltage; SINE(0 3.498 8k)
Named nets: 0, Vout, +Vdd, -Vdd, Vin, VoA
.tran 0 1m 0
.four 8k 10-1 V(Vout)
