Dinca-Mihai/Analog-Signal-Conditioning-Interface/OP1.asc

R1: res; 7.5k
R2: res; 5k
R3: res; 15k
Rbot1: res; {Rtot*alpha}
Rc1: res; 1.2
Rc2: res; 5k
Rtop1: res; {Rtot*(1-alpha)}
U1: AD820
V1: voltage; 0; AC 1
V2: voltage; 5
V3: voltage; -5
Named nets: 0, +VCC, -VCC, Vin, Vout
.param Rtot = 10k
.param alpha =0.5
.op
