Dinca-Mihai/Analog-Signal-Conditioning-Interface/THD2.asc

C1: cap; 20n
C2: cap; 20n
R1: res; 1k
R2: res; 1k
R3: res; 1k
R4: res; 1k
R5: res; 1k
R6: res; 1k
U1: AD820
U2: AD820
U3: AD820
V1: voltage; 5
V2: voltage; -5
VinET2_max: voltage; SINE(0 1.521 8k)
VinET2_min: voltage; SINE(0 555m 8k)
Named nets: 0, +VCC, -VCC, Vout_TB, Vout_TJ, Vout, VinET2_max, VinET2_min
.four 8k 10-1 V(Vout_TB)
.tran 2m
